TEA-Lab/DOGlove/docs/chapters/the_hardware.md

# Hardware

DOGlove’s hardware consists of two main components: the electronics for sensing and control, and the mechanical structure for physical interaction.

```{toctree}
:hidden:
:maxdepth: 1

../hardware/01_circuit.rst
../hardware/02_mechanical.md
```

## Circuit Design

Learn how we designed the electronics for DOGlove, including the schematic, PCB layout, and how to import or preview the project:

* [Circuit Design](../hardware/01_circuit.rst)

## Mechanical Design

Explore the mechanical structure of DOGlove through a full Onshape model, which can be exported in various formats:

* [Mechanical Design](../hardware/02_mechanical.md)
