TEA-Lab/DOGlove/docs/_static/quick_start/pcba/BOM_DOGlove_MainBoard_DOGlove_MainBoard.xlsx

No. | Quantity | Comment | Designator | Footprint | Value | Manufacturer Part | Manufacturer | Supplier Part | Supplier
1 | 2 | 10uF | C1,C2 | CASE-C_6032 | 10uF | TAJC106K035RNJ | Kyocera AVX | C7211 | LCSC
2 | 1 | 4.7uF | C3 | C0603 | 4.7uF | CL10A475KO8NNNC | SAMSUNG(三星) | C19666 | LCSC
3 | 3 | 100nF | C4,C5,C23 | C0603 | 100nF | CL10B104KB8NNNC | SAMSUNG(三星) | C1591 | LCSC
4 | 16 | 10nF | C6,C7,C8,C9,C10,C11,C12,C13,C14,C15,C16,C17,C18,C19,C20,C21 | C0603 | 10nF | CC0603JRX7R9BB103 | YAGEO(国巨) | C115056 | LCSC
5 | 1 | 47uF | C22 | CAP-SMD_L3.5-W2.8-R-RD | 47uF | CA45-B-16V-47uF-K | CEC(振华新云) | C136751 | LCSC
6 | 1 | 100pF | C24 | C0603 | 100pF | CL10C101JB8NNNC | SAMSUNG(三星) | C14858 | LCSC
7 | 5 | 1uF | C25,C26,C27,C28,C29 | C0603 | 1uF | CL10A105KB8NNNC | SAMSUNG(三星) | C15849 | LCSC
8 | 1 | XH-3AW | CN1 | CONN-TH_3P-P2.54_HCTL_XH-3AW |  | XH-3AW | HCTL(华灿天禄) | C2908612 | LCSC
9 | 3 | B3B-EH-A(LF)(SN) | CN2,CN3,CN4 | CONN-TH_B3B-EH-A-LF-SN |  | B3B-EH-A(LF)(SN) | JST | C160259 | LCSC
10 | 1 | XT30UPB-M | CN5 | CONN-TH_XT30UPB-M |  | XT30UPB-M | AMASS(艾迈斯) | C428721 | LCSC
11 | 1 | XT30PW-M30.G.Y | CN6 | CONN-TH_XT30PW-M |  | XT30PW-M30.G.Y | AMASS(艾迈斯) | C431092 | LCSC
12 | 1 | PZ254V-11-04P | H1 | HDR-TH_4P-P2.54-V-M |  | PZ254V-11-04P | XFCN(兴飞) | C2691448 | LCSC
13 | 4 | PZ254V-11-02P | H2,H3,H4,H5 | HDR-TH_2P-P2.54-V-M |  | PZ254V-11-02P | XFCN(兴飞) | C492401 | LCSC
14 | 2 | PZ254V-11-03P | H6,H7 | HDR-TH_3P-P2.54-V-M |  | PZ254V-11-03P | XFCN(兴飞) | C2937625 | LCSC
15 | 2 | NCD0603R1 | LED1,LED2 | LED0603-RD_RED |  | NCD0603R1 | 国星光电 | C84263 | LCSC
16 | 2 | NCD0603G1 | LED3,LED4 | LED0603-RD_1 |  | NCD0603G1 | 国星光电 | C84267 | LCSC
17 | 18 | 10kΩ | R1,R3,R35,R36,R37,R38,R39,R40,R41,R42,R43,R44,R45,R46,R47,R48,R49,R50 | R0603 | 10kΩ | 0603WAF1002T5E | UNI-ROYAL(厚声) | C25804 | LCSC
18 | 1 | NC | R2 | R0603 | NC | 0603WAF0000T5E | UNI-ROYAL(厚声) |  | LCSC
19 | 6 | 0Ω | R4,R13,R24,R25,R31,R33 | R0603 | 0Ω | 0603WAF0000T5E | UNI-ROYAL(厚声) | C21189 | LCSC
20 | 4 | 4.7kΩ | R5,R6,R7,R8 | R0603 | 4.7kΩ | 0603WAF4701T5E | UNI-ROYAL(厚声) | C23162 | LCSC
21 | 16 | 1kΩ | R9,R10,R11,R12,R14,R15,R16,R17,R18,R19,R20,R21,R26,R27,R28,R29 | R0603 | 1kΩ | 0603WAF1001T5E | UNI-ROYAL(厚声) | C21190 | LCSC
22 | 5 | 100Ω | R22,R23,R30,R32,R34 | R0603 | 100Ω | 0603WAF1000T5E | UNI-ROYAL(厚声) | C22775 | LCSC
23 | 1 | LM1117MPX-3.3/NOPB | U1 | SOT-223-3_L6.5-W3.4-P2.30-LS7.0-BR |  | LM1117MPX-3.3/NOPB | TI(德州仪器) | C9662 | LCSC
24 | 1 | STM32F042K6T6 | U2 | LQFP-32_L7.0-W7.0-P0.80-LS9.0-BL |  | STM32F042K6T6 | ST(意法半导体) | C69216 | LCSC
25 | 2 | ADS1256IDBR | U3,U4 | SSOP-28_L10.2-W5.3-P0.65-LS7.8-BL |  | ADS1256IDBR | TI(德州仪器) | C28186 | LCSC
26 | 1 | TL431BIDBZR | U5 | SOT-23-3_L2.9-W1.3-P1.90-LS2.4-BR |  | TL431BIDBZR | TI(德州仪器) | C41283 | LCSC
27 | 1 | PCA9548APW,118 | U6 | TSSOP-24_L7.8-W4.4-P0.65-LS6.4-BL |  | PCA9548APW,118 | NXP(恩智浦) | C21198 | LCSC
28 | 5 | DRV2605LDGSR | U7,U8,U9,U10,U11 | VSSOP-10_L3.0-W3.0-P0.50-LS4.9-BL |  | DRV2605LDGSR | TI(德州仪器) | C527464 | LCSC
29 | 16 | JS20T-S03PHA-00 | U12,U13,U14,U15,U18,U19,U20,U21,U24,U25,U26,U27,U29,U30,U31,U32 | CONN-TH_3P-P2.00_BX-PH2.0-3PZZ |  | JS20T-S03PHA-00 | JS(钜硕电子) | C7499293 | LCSC
30 | 5 | ZX-SH1.0-2PLT | U16,U17,U22,U23,U28 | CONN-SMD_2P-P1.00_MEGASTAR_ZX-SH1.0-2PLT |  | ZX-SH1.0-2PLT | Megastar(兆星) | C7430451 | LCSC
31 | 1 | SS-22F07-G100 | U33 | SW-TH_6P-L16.5-W7.5-P4.0-LS2.6-TL |  | SS-22F07-G100 | G-Switch(品赞) | C5446810 | LCSC
32 | 3 | {ManufacturerPart!} | X1,X2,X3 | OSC-SMD_3P-L3.2-W1.3-P1.20 |  | CSTNE8M00G520000R0 | muRata(村田) | C907975 | LCSC
