TEA-Lab/DOGlove/DOGlove_meshes/pinky_bend_2.STL

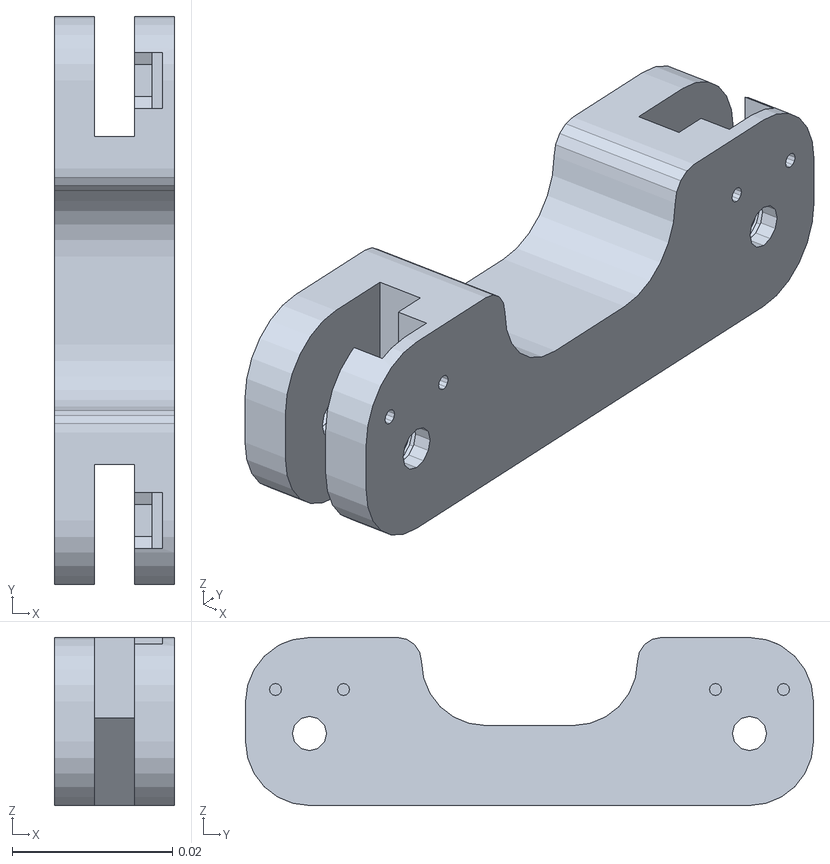
[picture p16: CAD file, 2025-06-23]
DOGlove_meshes/pinky_bend_2.STL
0.015 x 0.071 x 0.021
