TEA-Lab/DOGlove/hand_meshes/inspire_hand/meshes/Link11.STL

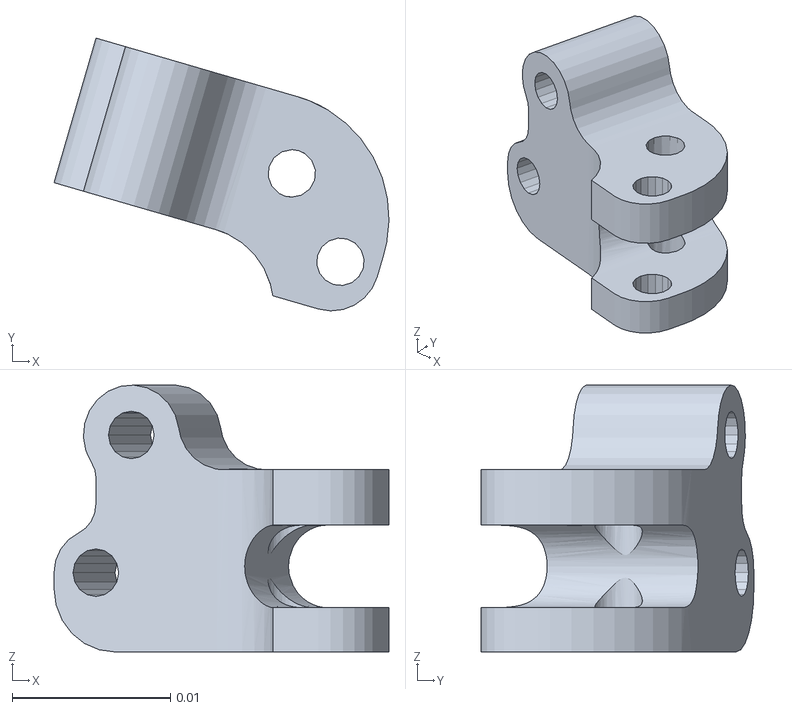
[picture p17: CAD file, 2026-03-28]
hand_meshes/inspire_hand/meshes/Link11.STL
0.0211 x 0.0172 x 0.0168
