TEA-Lab/DOGlove/hand_meshes/leap_hand/meshes/thumb_pip.stl

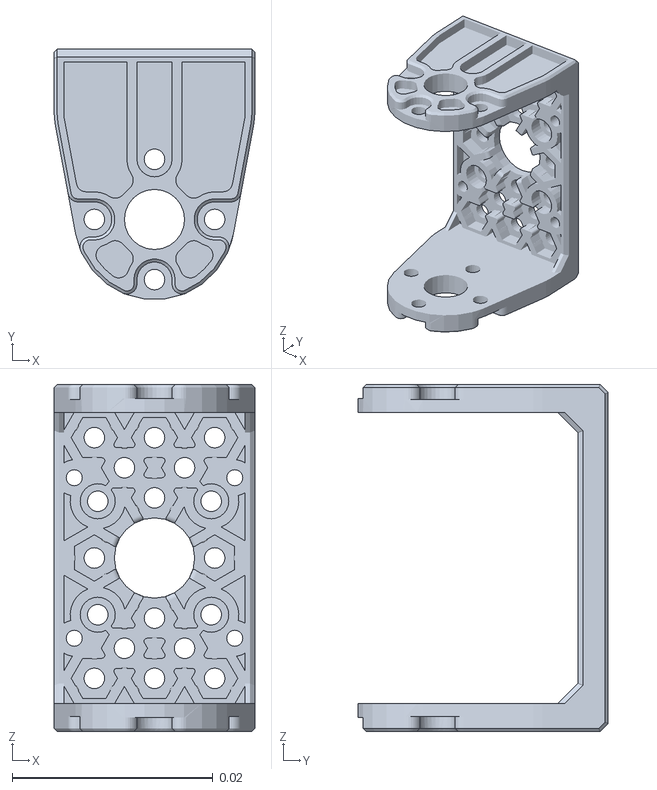
[picture p18: CAD file, 2026-03-28]
hand_meshes/leap_hand/meshes/thumb_pip.stl
0.02 x 0.0249 x 0.0346
