TEA-Lab/DOGlove/hand_meshes/shadow_hand/assets/th_proximal.obj

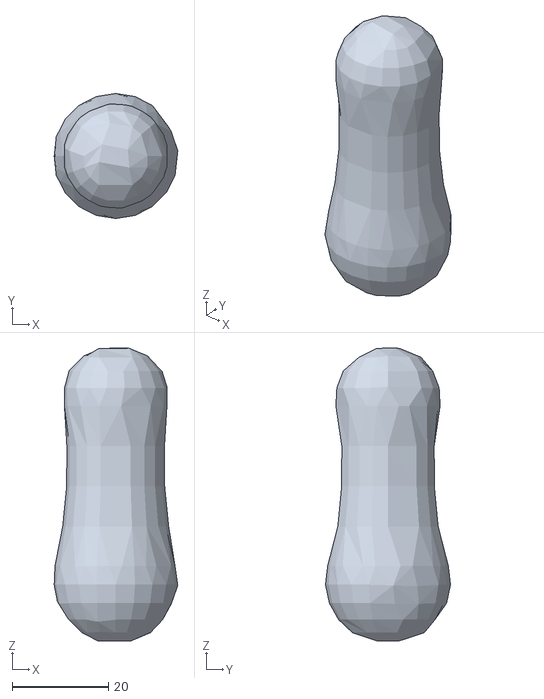
[picture p19: CAD file, 2026-03-28]
hand_meshes/shadow_hand/assets/th_proximal.obj
25.7 x 26.0 x 60.8
