TEA-Lab/DOGlove/hand_meshes/wonik_allegro/assets/link_12.0_left.stl

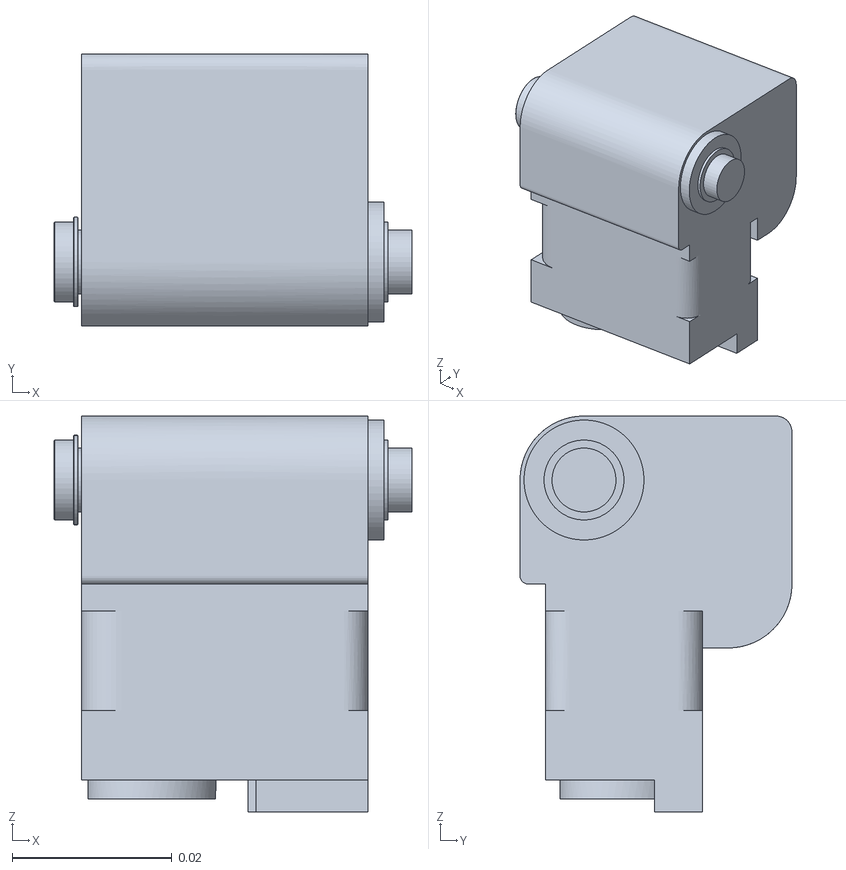
[picture p20: CAD file, 2026-03-28]
hand_meshes/wonik_allegro/assets/link_12.0_left.stl
0.0447 x 0.034 x 0.0495
