TEA-Lab/DOGlove/DOGlove_meshes/index_bend_3.STL

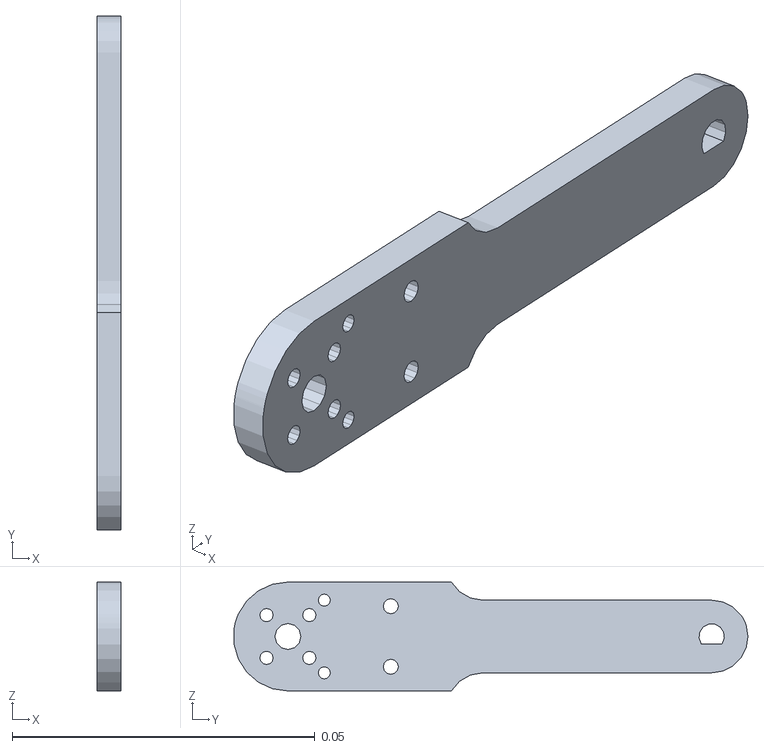
[picture p21: CAD file, 2025-06-23]
DOGlove_meshes/index_bend_3.STL
0.004 x 0.0849 x 0.018
