TEA-Lab/DOGlove/hand_meshes/inspire_hand/meshes/Link14.STL

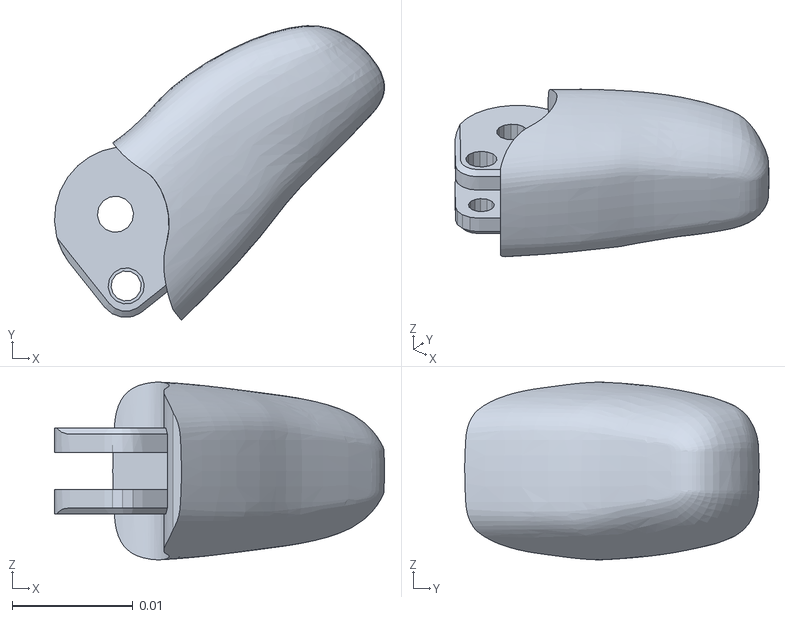
[picture p22: CAD file, 2026-03-28]
hand_meshes/inspire_hand/meshes/Link14.STL
0.0273 x 0.0244 x 0.0147
