TEA-Lab/DOGlove/hand_meshes/leap_hand/meshes/thumb_dip.stl

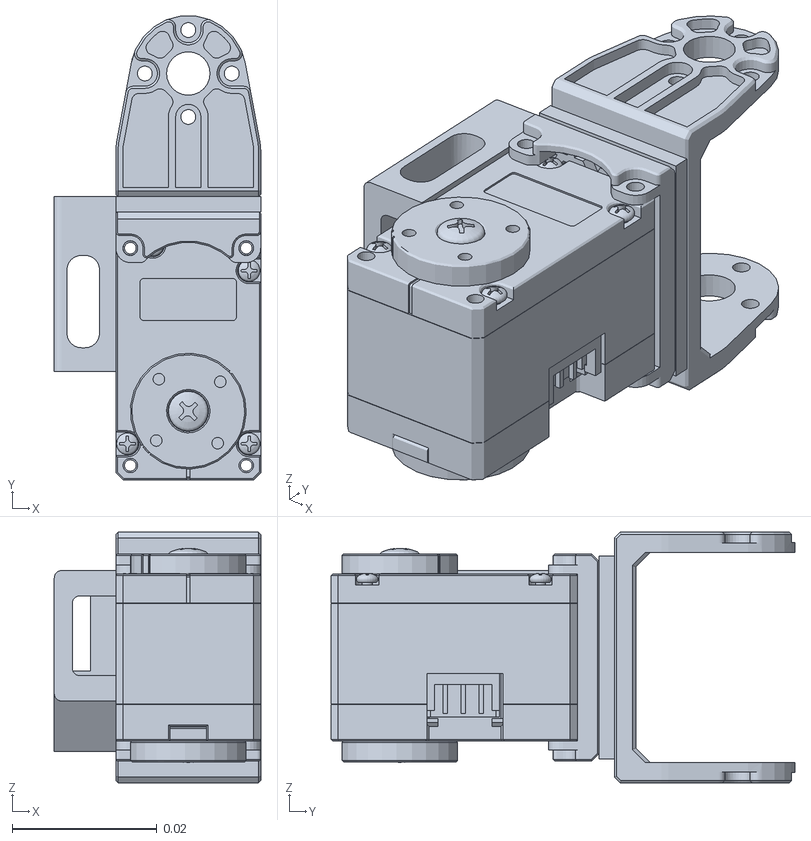
[picture p23: CAD file, 2026-03-28]
hand_meshes/leap_hand/meshes/thumb_dip.stl
0.0285 x 0.064 x 0.0346
