TEA-Lab/DOGlove/hand_meshes/shadow_hand/assets/th_distal_pst.obj

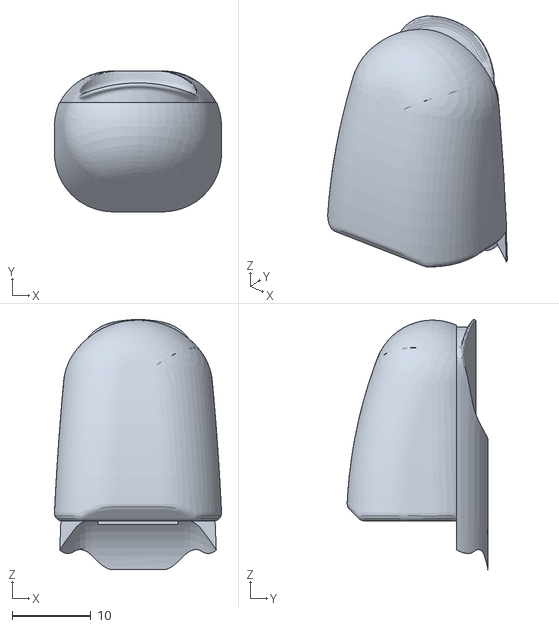
[picture p24: CAD file, 2026-03-28]
hand_meshes/shadow_hand/assets/th_distal_pst.obj
21.2 x 17.8 x 31.7
