TEA-Lab/DOGlove/DOGlove_meshes/middle_split.STL

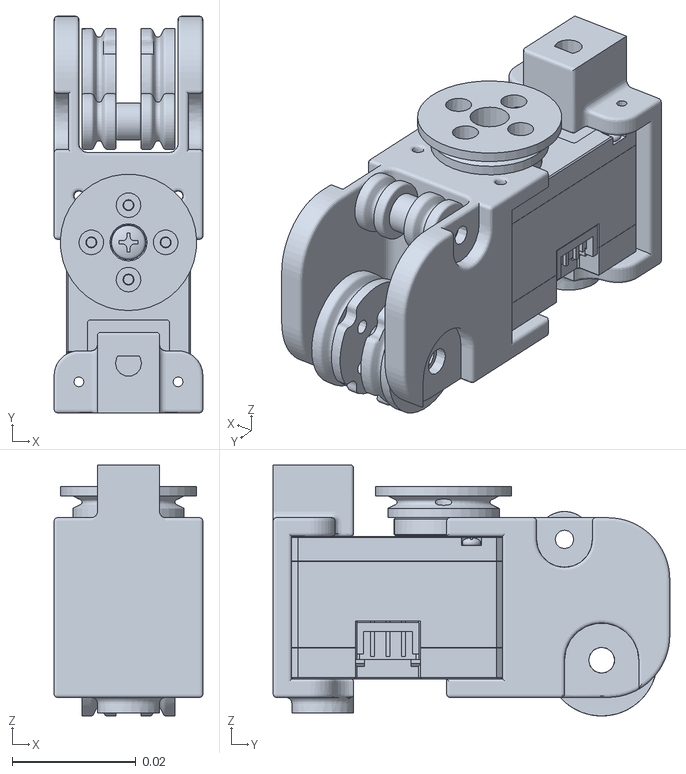
[picture p26: CAD file, 2025-06-23]
DOGlove_meshes/middle_split.STL
0.024 x 0.064 x 0.0405
