TEA-Lab/DOGlove/hand_meshes/inspire_hand/meshes/Link19.STL

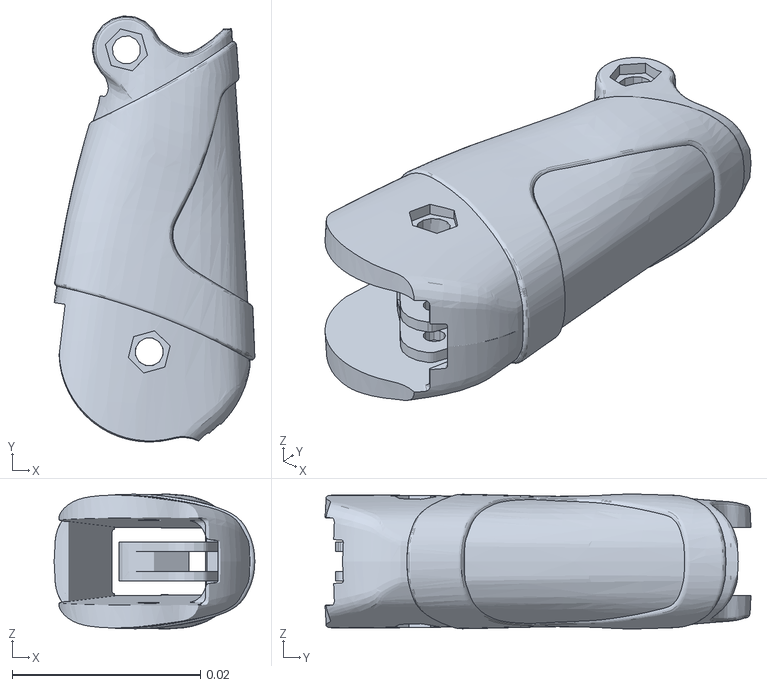
[picture p27: CAD file, 2026-03-28]
hand_meshes/inspire_hand/meshes/Link19.STL
0.0213 x 0.0452 x 0.0143
