TEA-Lab/DOGlove/hand_meshes/leap_hand/meshes/pip.stl

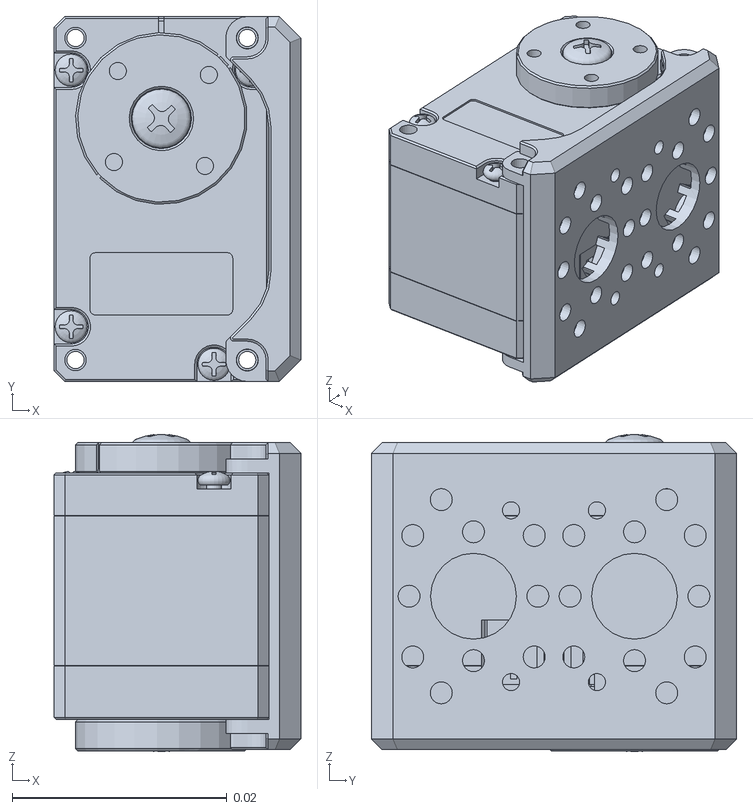
[picture p28: CAD file, 2026-03-28]
hand_meshes/leap_hand/meshes/pip.stl
0.023 x 0.034 x 0.0295
