TEA-Lab/DOGlove/hand_meshes/shadow_hand/assets/f_distal_pst.obj

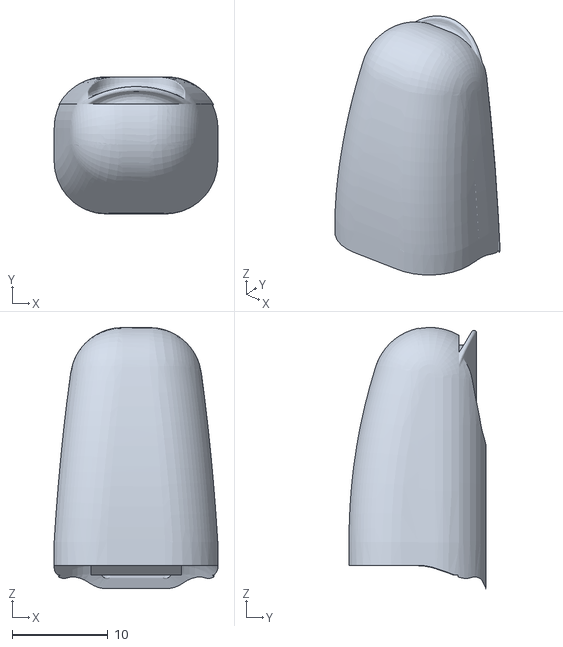
[picture p29: CAD file, 2026-03-28]
hand_meshes/shadow_hand/assets/f_distal_pst.obj
17.1 x 14.3 x 27.3
