TEA-Lab/DOGlove/hand_meshes/wonik_allegro/assets/link_15.0_tip.stl

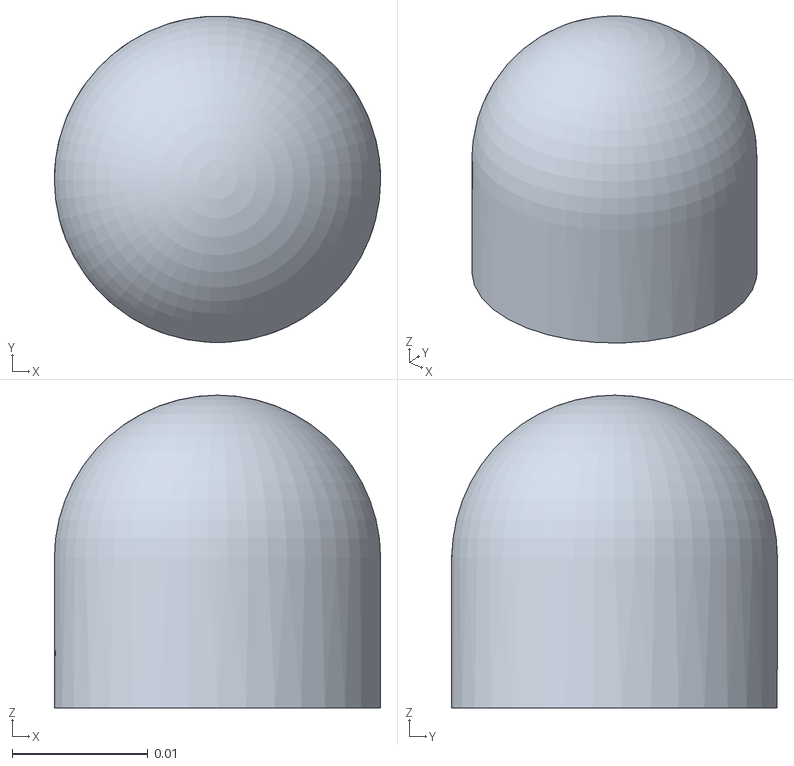
[picture p30: CAD file, 2026-03-28]
hand_meshes/wonik_allegro/assets/link_15.0_tip.stl
0.024 x 0.024 x 0.023
