TEA-Lab/DOGlove/DOGlove_meshes/thumb_bend_1.STL

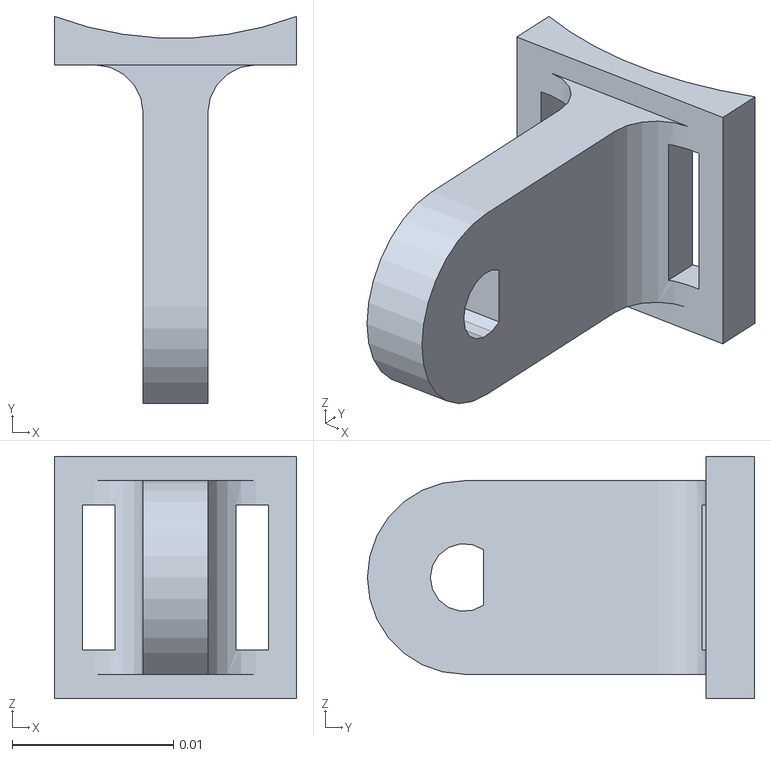
[picture p31: CAD file, 2025-06-23]
DOGlove_meshes/thumb_bend_1.STL
0.015 x 0.024 x 0.015
