TEA-Lab/DOGlove/hand_meshes/leap_hand/meshes/mcp_joint.stl

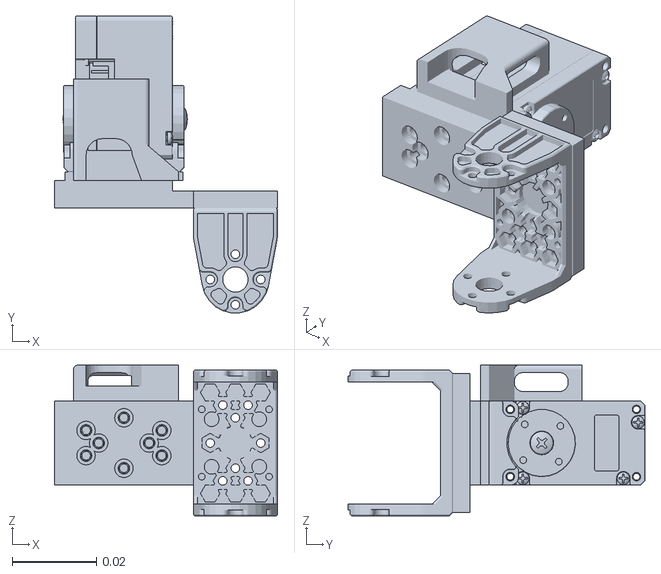
[picture p32: CAD file, 2026-03-28]
hand_meshes/leap_hand/meshes/mcp_joint.stl
0.053 x 0.0705 x 0.0358
