TEA-Lab/DOGlove/hand_meshes/shadow_hand/assets/wrist.obj

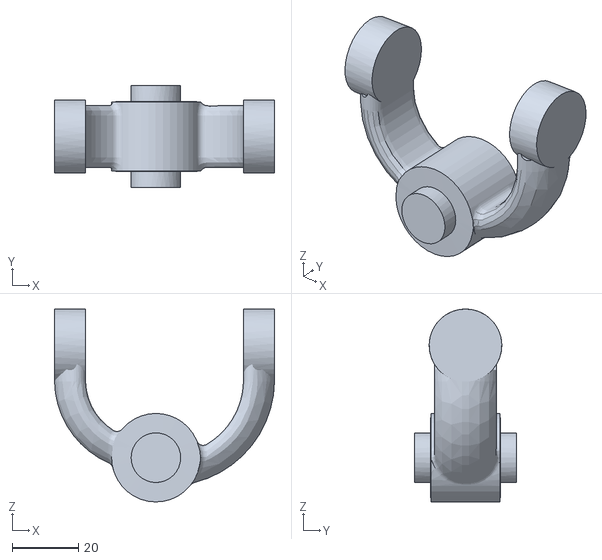
[picture p33: CAD file, 2026-03-28]
hand_meshes/shadow_hand/assets/wrist.obj
66.6 x 30.8 x 58.4
