TEA-Lab/DOGlove/hand_meshes/wonik_allegro/assets/link_13.0.stl

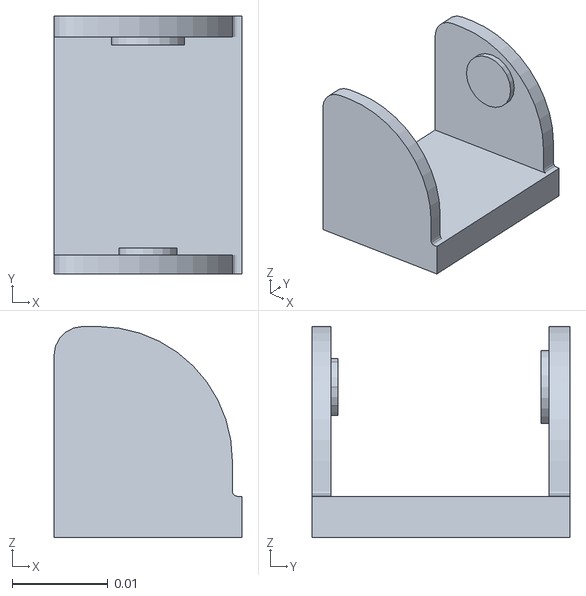
[picture p34: CAD file, 2026-03-28]
hand_meshes/wonik_allegro/assets/link_13.0.stl
0.0196 x 0.0269 x 0.022
