TEA-Lab/DOGlove/hand_meshes/inspire_hand/meshes/base_link.STL

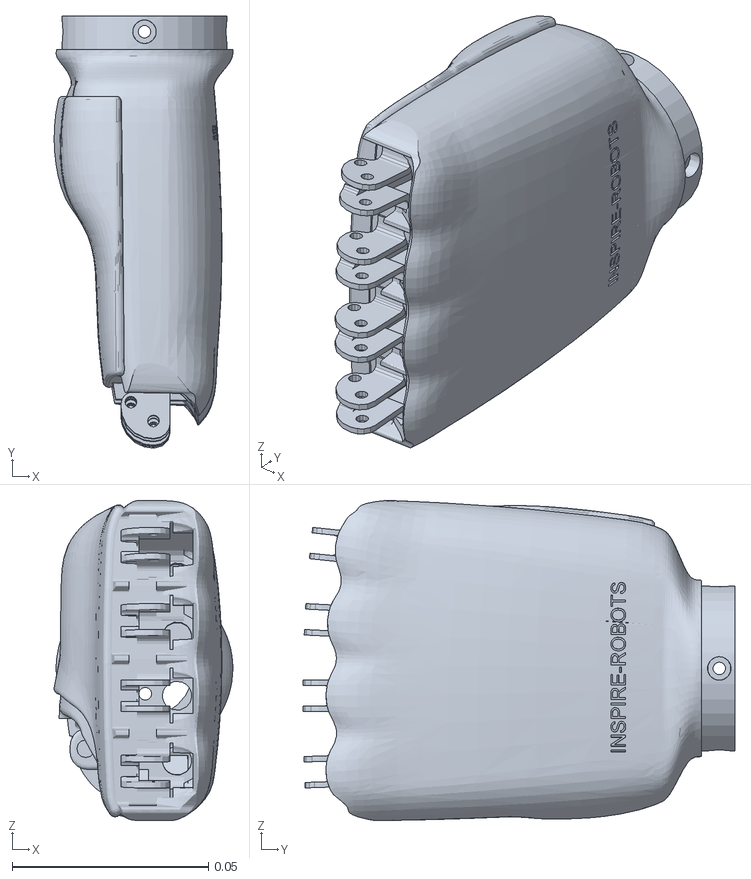
[picture p35: CAD file, 2026-03-28]
hand_meshes/inspire_hand/meshes/base_link.STL
0.0455 x 0.11 x 0.0815
