TEA-Lab/DOGlove/hand_meshes/leap_hand/meshes/dip.stl

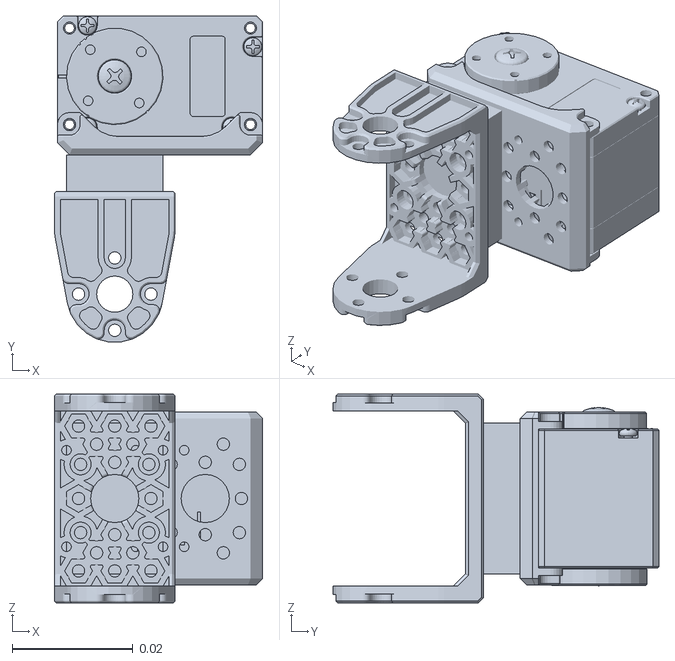
[picture p36: CAD file, 2026-03-28]
hand_meshes/leap_hand/meshes/dip.stl
0.0345 x 0.054 x 0.0346
