TEA-Lab/DOGlove/hand_meshes/shadow_hand/assets/f_knuckle.obj

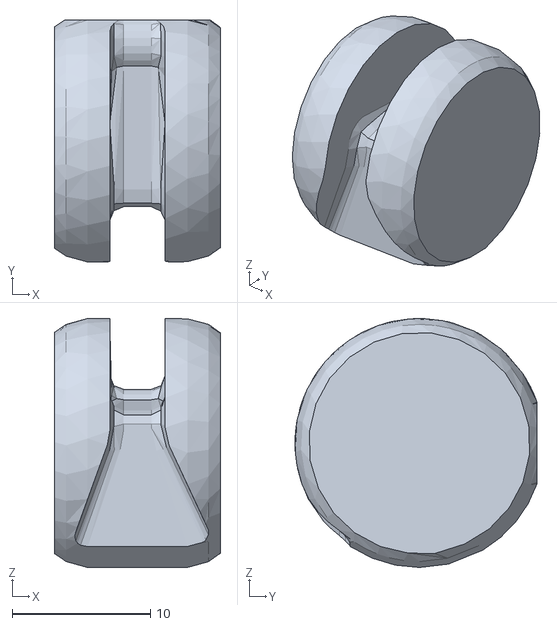
[picture p37: CAD file, 2026-03-28]
hand_meshes/shadow_hand/assets/f_knuckle.obj
12.0 x 17.5 x 18.0
