TEA-Lab/DOGlove/DOGlove_meshes/ring_bend_2.STL

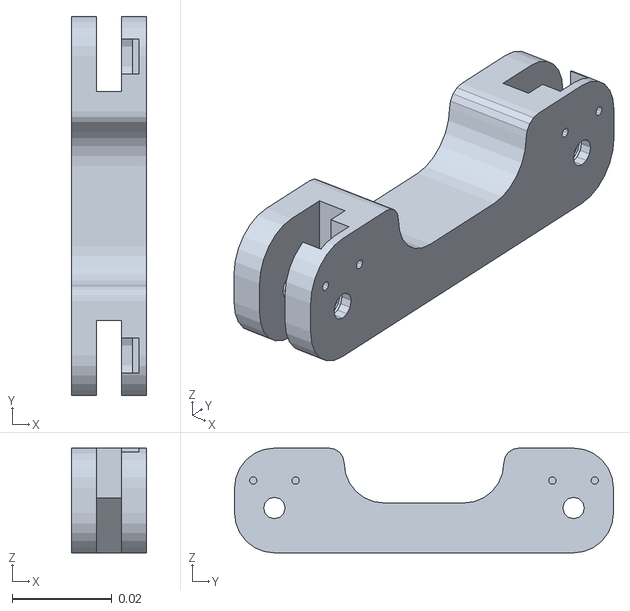
[picture p39: CAD file, 2025-06-23]
DOGlove_meshes/ring_bend_2.STL
0.015 x 0.076 x 0.021
