TEA-Lab/DOGlove/hand_meshes/inspire_hand/meshes/Link18.STL

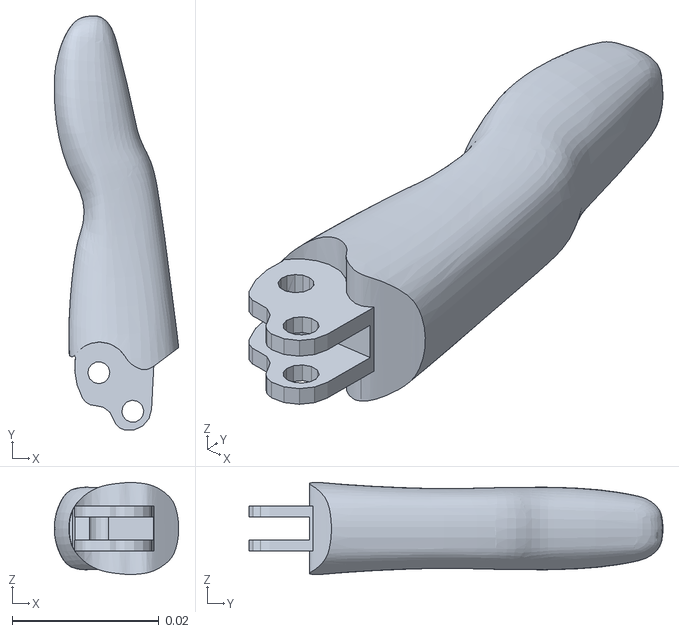
[picture p40: CAD file, 2026-03-28]
hand_meshes/inspire_hand/meshes/Link18.STL
0.017 x 0.0565 x 0.0126
