TEA-Lab/DOGlove/hand_meshes/leap_hand/meshes/fingertip.stl

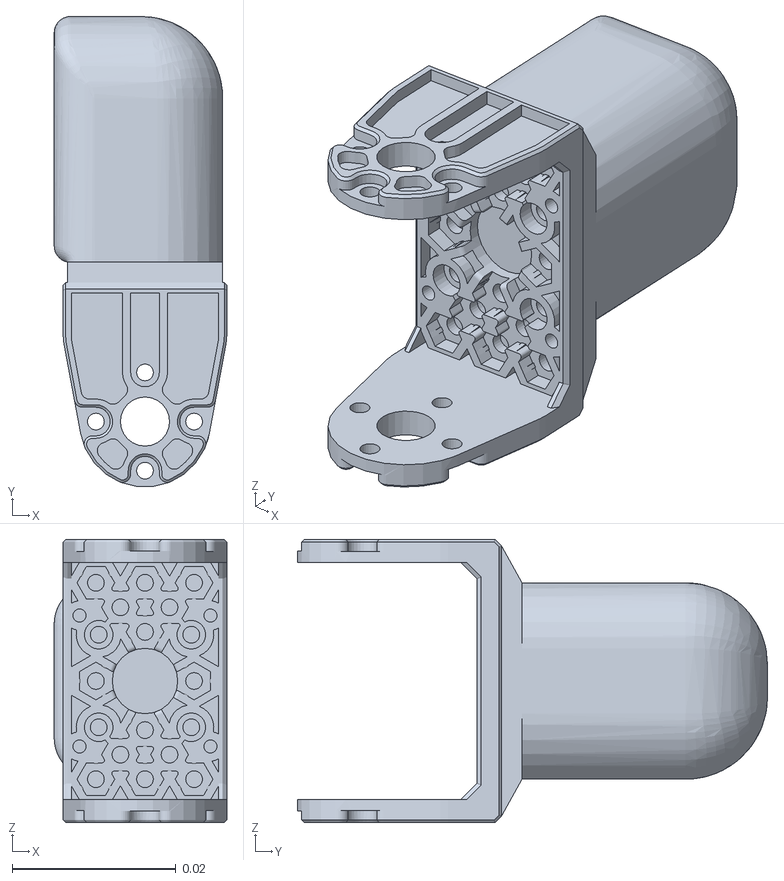
[picture p41: CAD file, 2026-03-28]
hand_meshes/leap_hand/meshes/fingertip.stl
0.0211 x 0.0574 x 0.0346
