TEA-Lab/DOGlove/hand_meshes/shadow_hand/assets/forearm_collision.obj

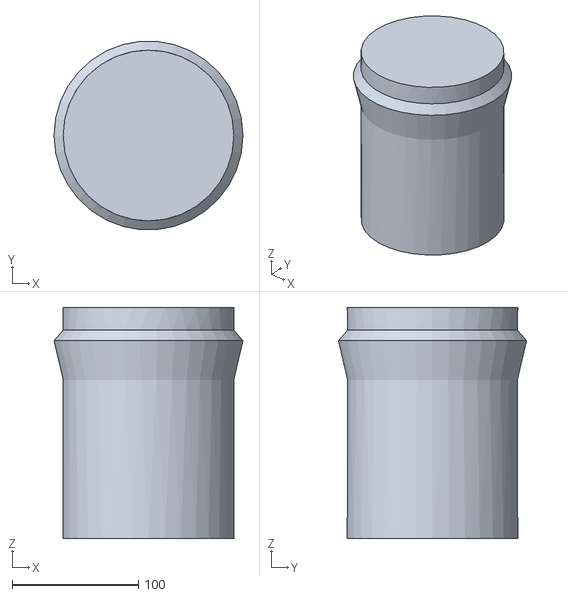
[picture p42: CAD file, 2026-03-28]
hand_meshes/shadow_hand/assets/forearm_collision.obj
149.5 x 148.9 x 182.8
