TEA-Lab/DOGlove/hand_meshes/wonik_allegro/assets/base_link.stl

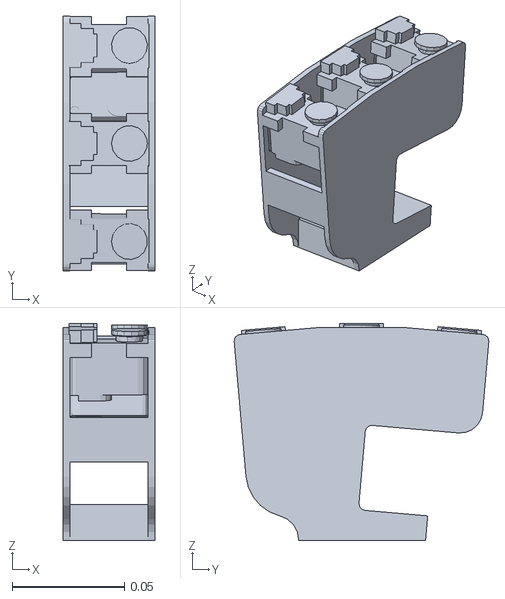
[picture p43: CAD file, 2026-03-28]
hand_meshes/wonik_allegro/assets/base_link.stl
0.0408 x 0.113 x 0.0967
