TEA-Lab/DOGlove/DOGlove_meshes/pinky_bend_3.STL

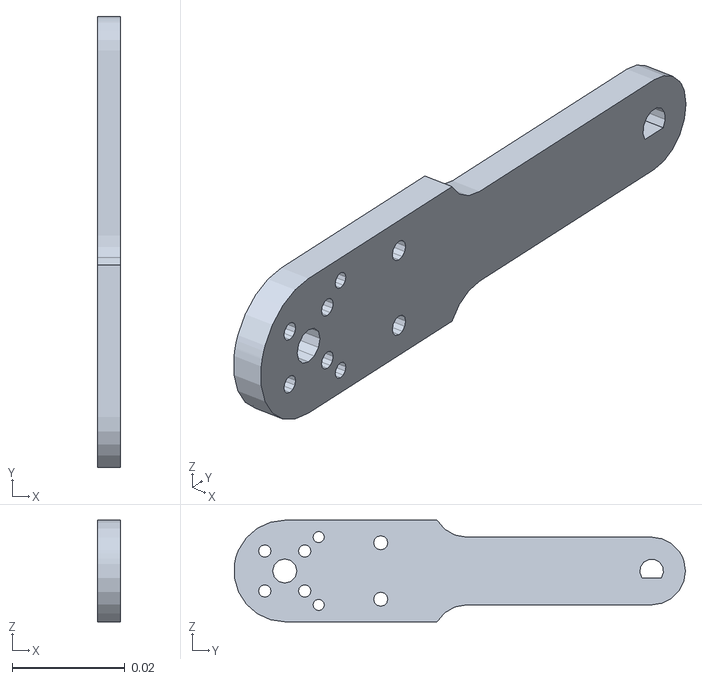
[picture p44: CAD file, 2025-06-23]
DOGlove_meshes/pinky_bend_3.STL
0.004 x 0.0799 x 0.018
