TEA-Lab/DOGlove/hand_meshes/leap_hand/meshes/thumb_fingertip.stl

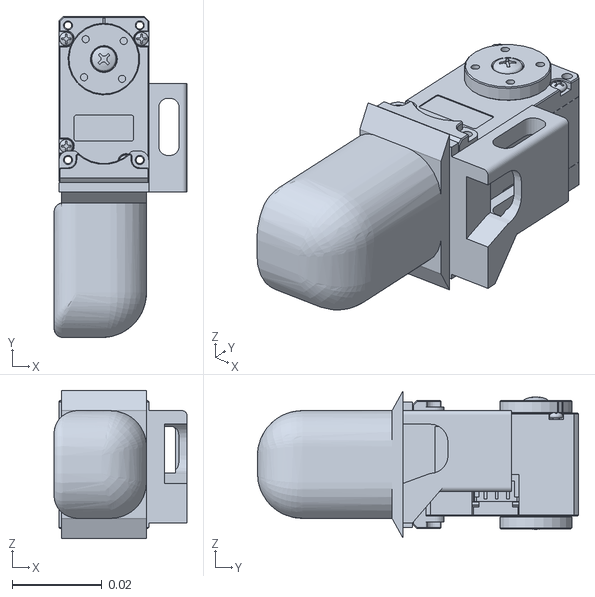
[picture p45: CAD file, 2026-03-28]
hand_meshes/leap_hand/meshes/thumb_fingertip.stl
0.0296 x 0.0716 x 0.033
