TEA-Lab/DOGlove/hand_meshes/shadow_hand/assets/forearm_1.obj

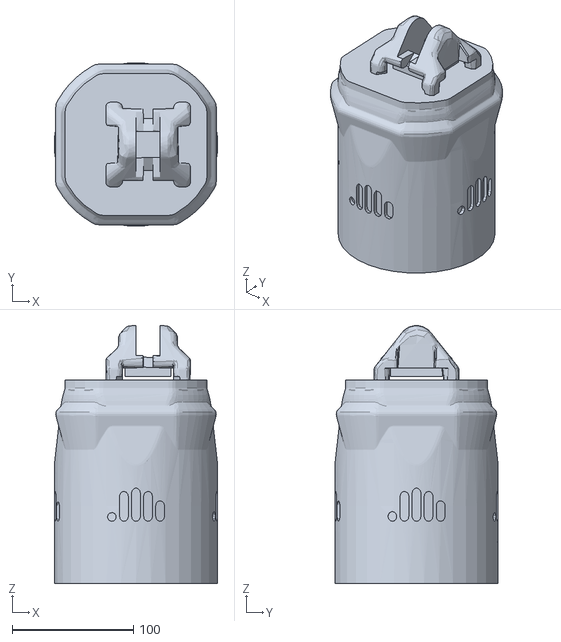
[picture p46: CAD file, 2026-03-28]
hand_meshes/shadow_hand/assets/forearm_1.obj
135.0 x 135.0 x 213.1
