TEA-Lab/DOGlove/hand_meshes/wonik_allegro/assets/link_1.0.stl

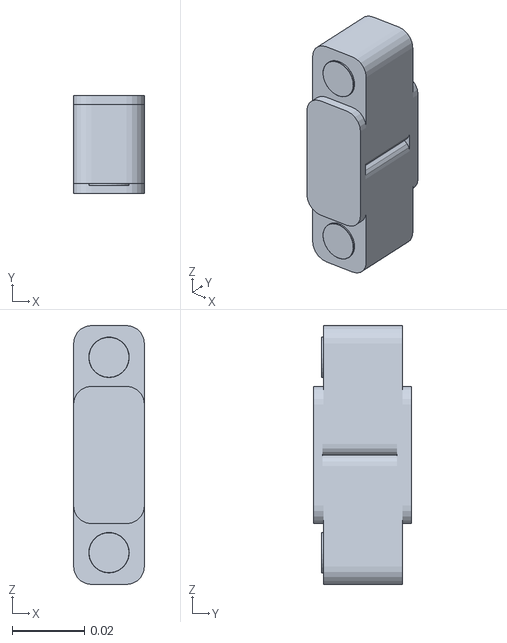
[picture p47: CAD file, 2026-03-28]
hand_meshes/wonik_allegro/assets/link_1.0.stl
0.0196 x 0.027 x 0.0716
