TEA-Lab/DOGlove/hand_meshes/inspire_hand/meshes/Link16.STL

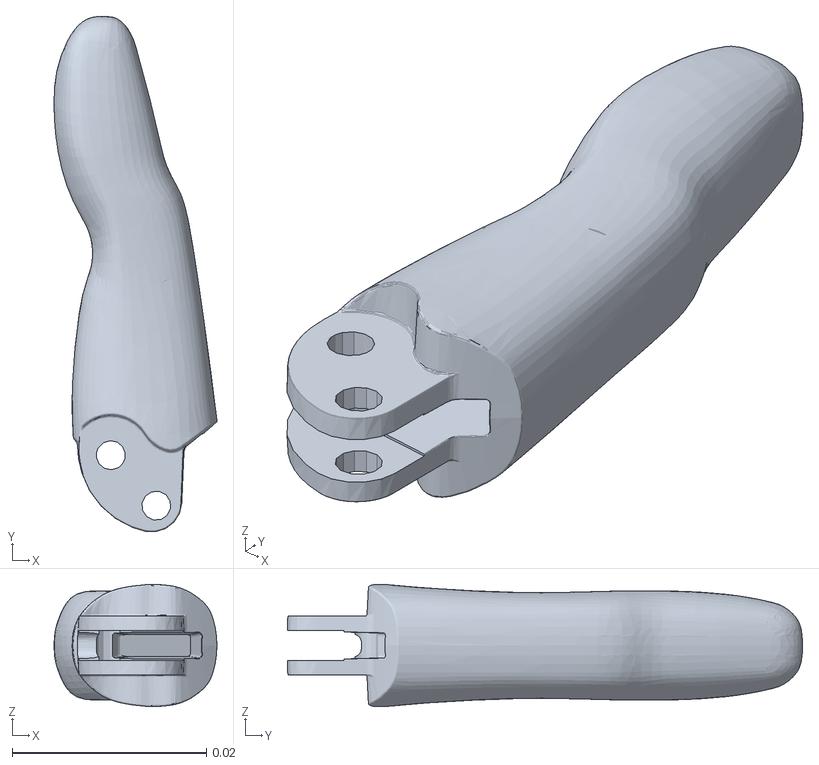
[picture p48: CAD file, 2026-03-28]
hand_meshes/inspire_hand/meshes/Link16.STL
0.0168 x 0.0531 x 0.0126
