TEA-Lab/DOGlove/hand_meshes/shadow_hand/assets/th_middle.obj

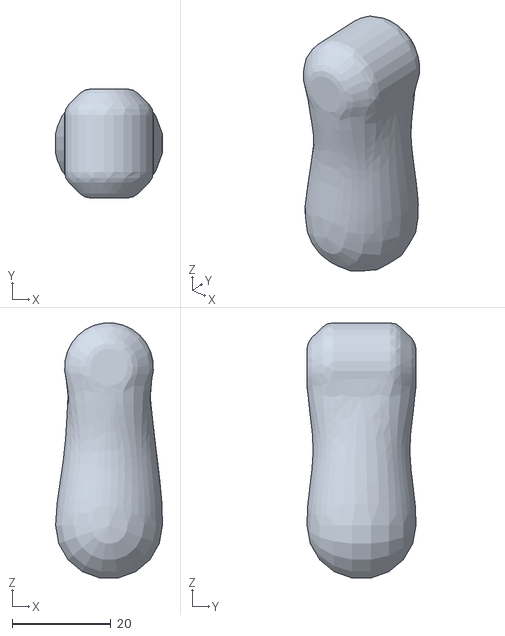
[picture p49: CAD file, 2026-03-28]
hand_meshes/shadow_hand/assets/th_middle.obj
21.6 x 22.1 x 51.6
