TEA-Lab/DOGlove/hand_meshes/inspire_hand/meshes/Link20.STL

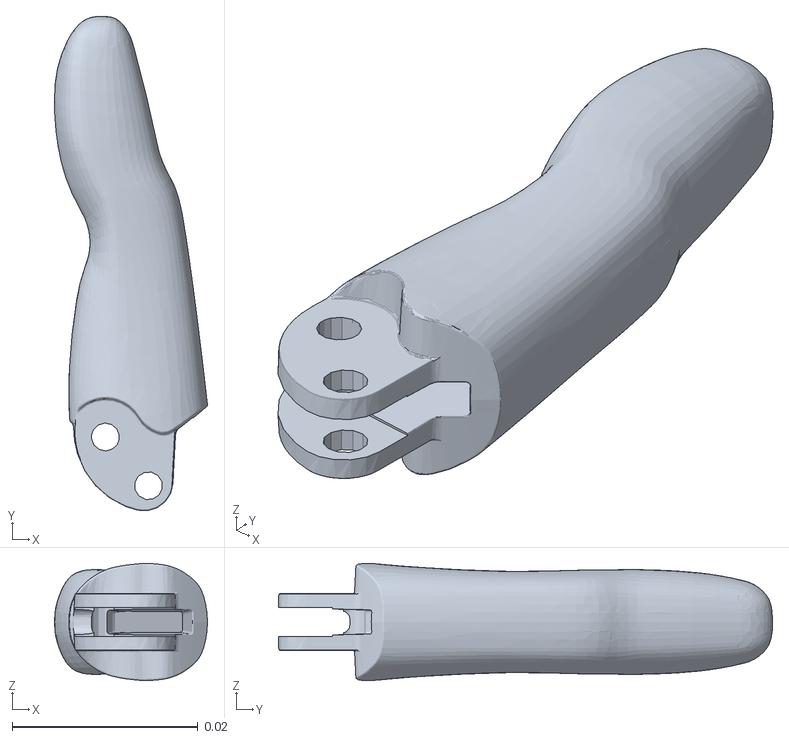
[picture p51: CAD file, 2026-03-28]
hand_meshes/inspire_hand/meshes/Link20.STL
0.0165 x 0.0532 x 0.0126
