TEA-Lab/DOGlove/hand_meshes/shadow_hand/assets/palm.obj

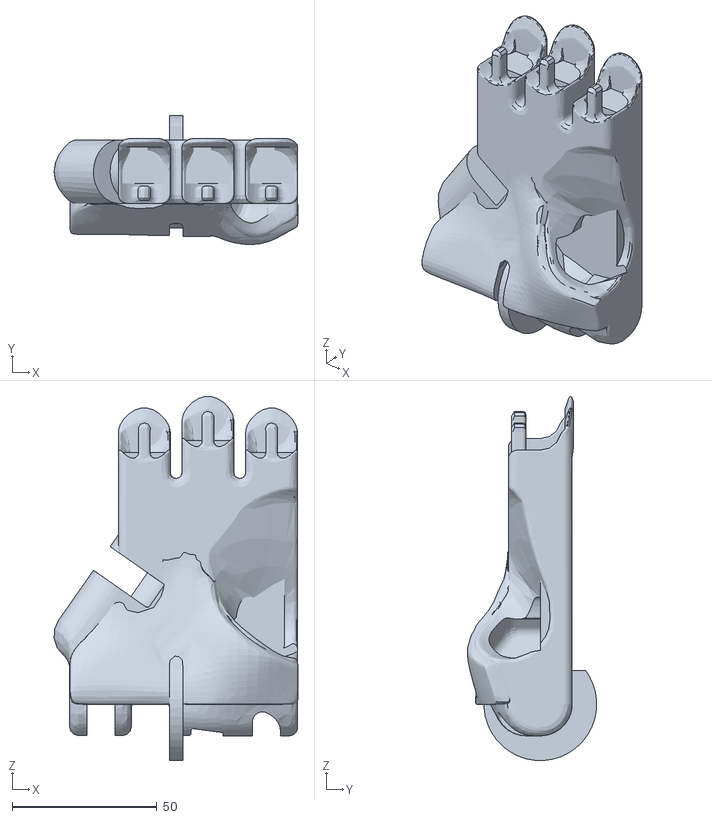
[picture p52: CAD file, 2026-03-28]
hand_meshes/shadow_hand/assets/palm.obj
84.3 x 44.7 x 125.8
