TEA-Lab/DOGlove/hand_meshes/inspire_hand/meshes/hand_base_link.STL

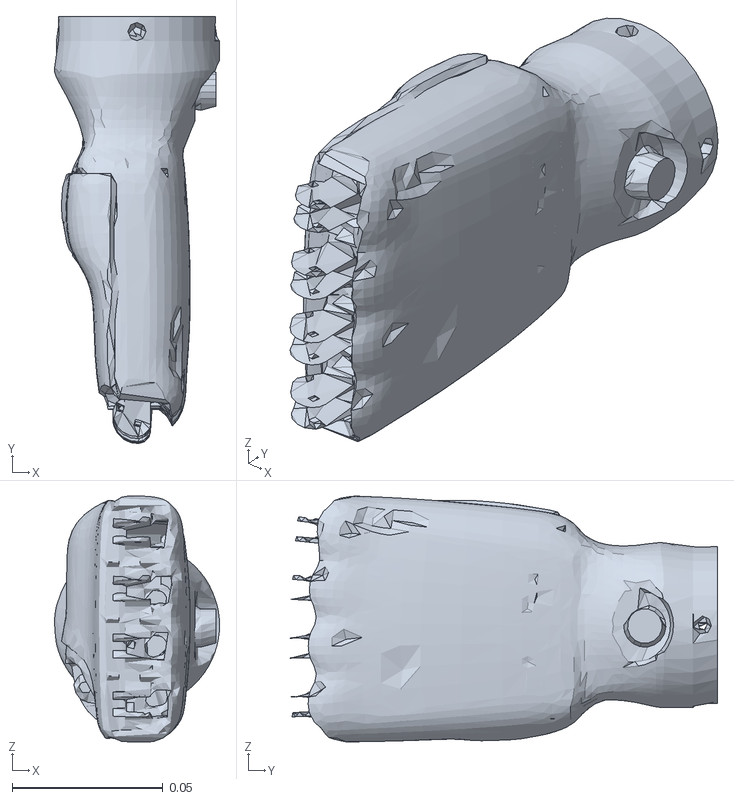
[picture p53: CAD file, 2026-03-28]
hand_meshes/inspire_hand/meshes/hand_base_link.STL
0.0547 x 0.142 x 0.0815
