TEA-Lab/DOGlove/hand_meshes/shadow_hand/assets/f_proximal.obj

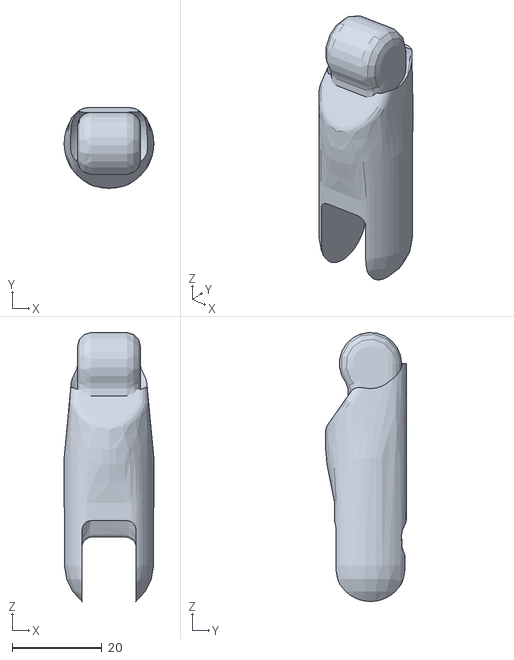
[picture p54: CAD file, 2026-03-28]
hand_meshes/shadow_hand/assets/f_proximal.obj
20.0 x 18.0 x 59.9
