TEA-Lab/DOGlove/DOGlove_meshes/thumb_bend_2.STL

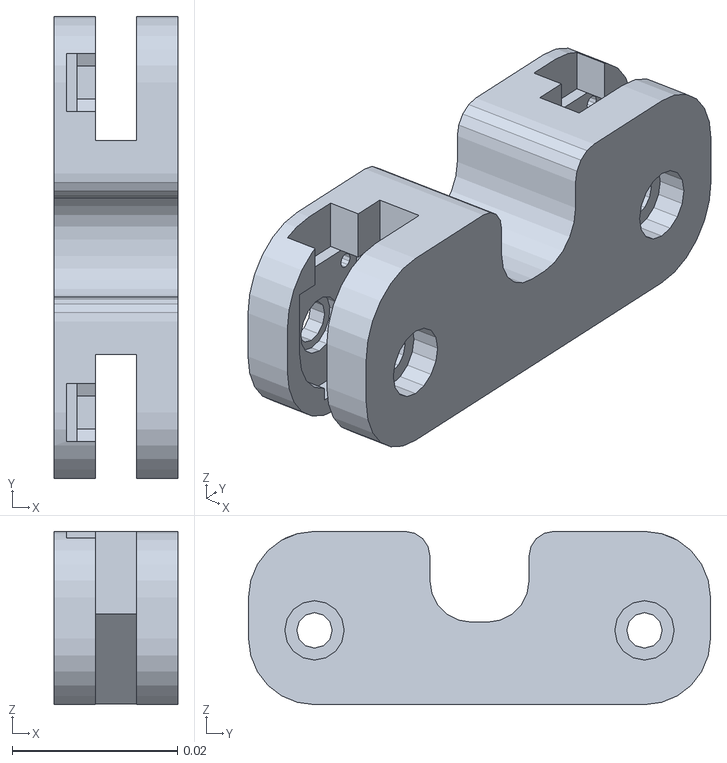
[picture p56: CAD file, 2025-06-23]
DOGlove_meshes/thumb_bend_2.STL
0.015 x 0.056 x 0.021
