TEA-Lab/DOGlove/hand_meshes/inspire_hand/meshes/Link22.STL

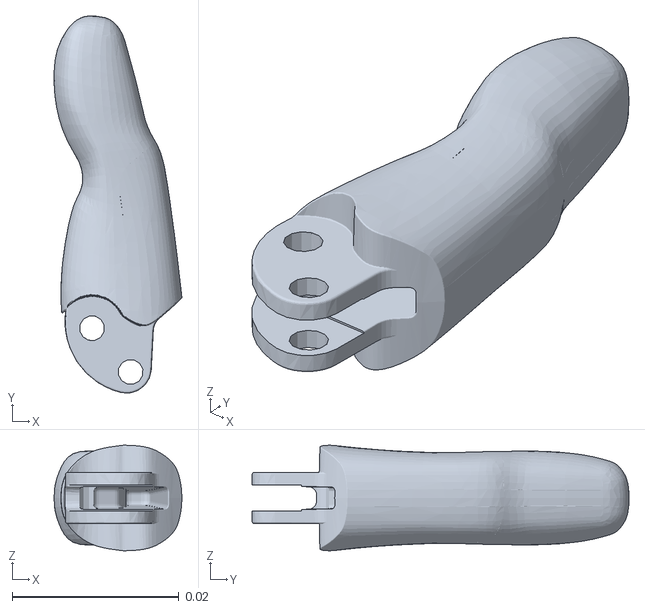
[picture p57: CAD file, 2026-03-28]
hand_meshes/inspire_hand/meshes/Link22.STL
0.0153 x 0.0452 x 0.0127
