TEA-Lab/DOGlove/hand_meshes/shadow_hand/assets/lf_metacarpal.obj

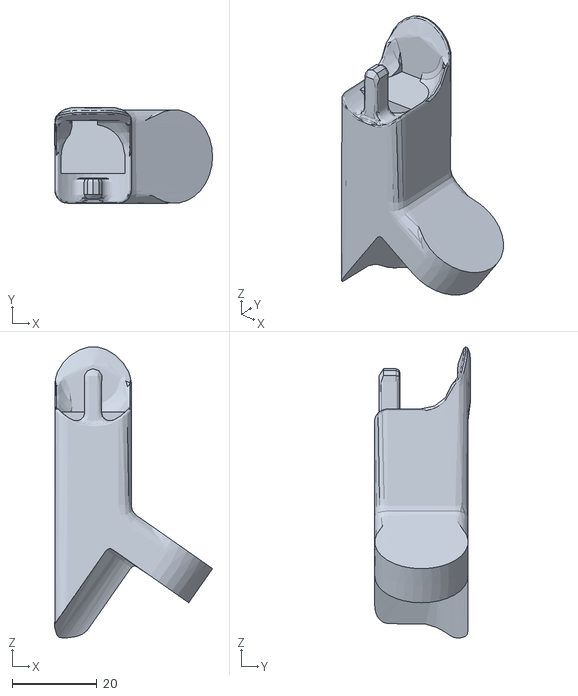
[picture p58: CAD file, 2026-03-28]
hand_meshes/shadow_hand/assets/lf_metacarpal.obj
37.3 x 22.5 x 68.5
