TEA-Lab/DOGlove/hand_meshes/wonik_allegro/assets/link_12.0_right.stl

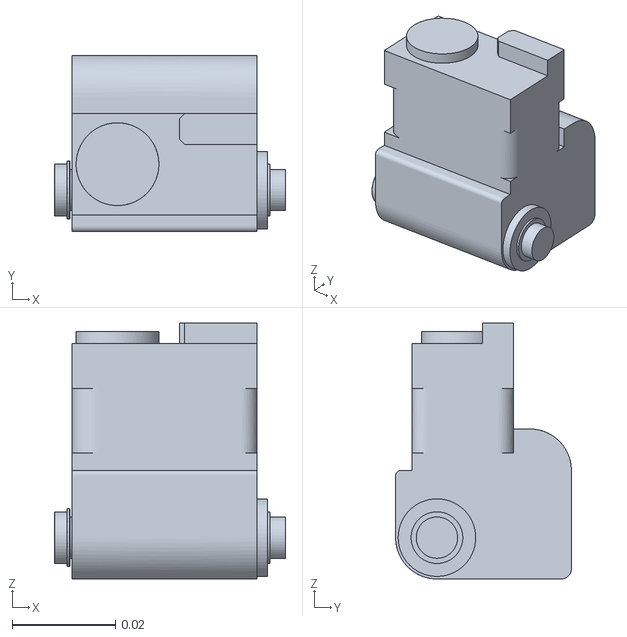
[picture p59: CAD file, 2026-03-28]
hand_meshes/wonik_allegro/assets/link_12.0_right.stl
0.0447 x 0.034 x 0.0495
