TEA-Lab/DOGlove/hand_meshes/inspire_hand/meshes/Link13.STL

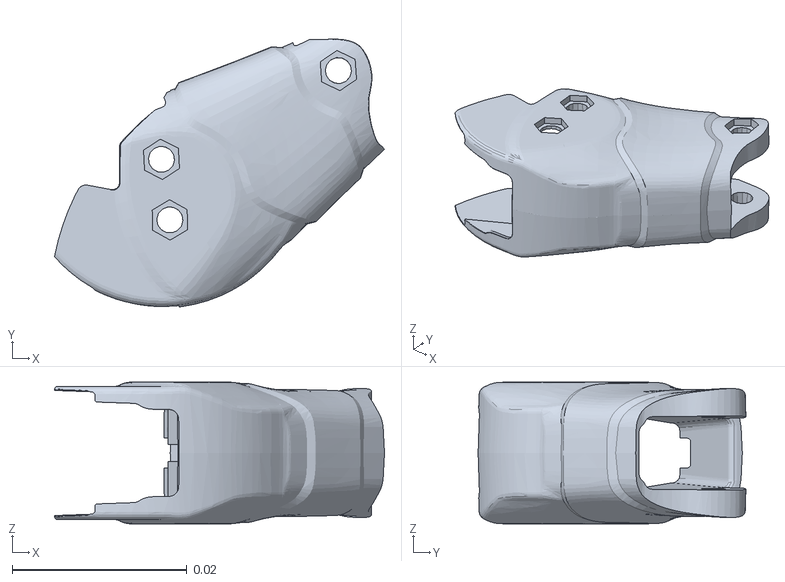
[picture p60: CAD file, 2026-03-28]
hand_meshes/inspire_hand/meshes/Link13.STL
0.0378 x 0.0306 x 0.0162
