TEA-Lab/DOGlove/hand_meshes/shadow_hand/assets/forearm_0.obj

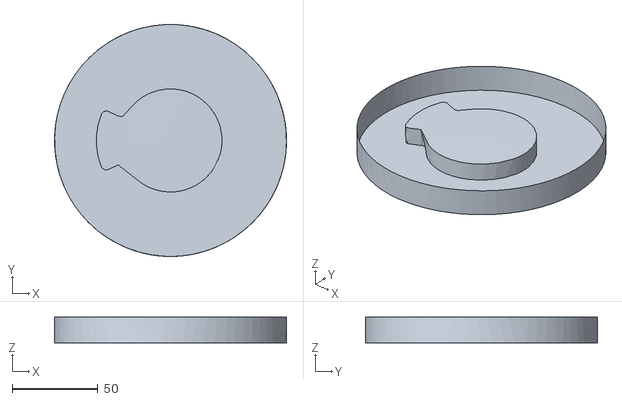
[picture p61: CAD file, 2026-03-28]
hand_meshes/shadow_hand/assets/forearm_0.obj
135.0 x 135.0 x 15.0
