TEA-Lab/DOGlove/DOGlove_meshes/thumb_split.STL

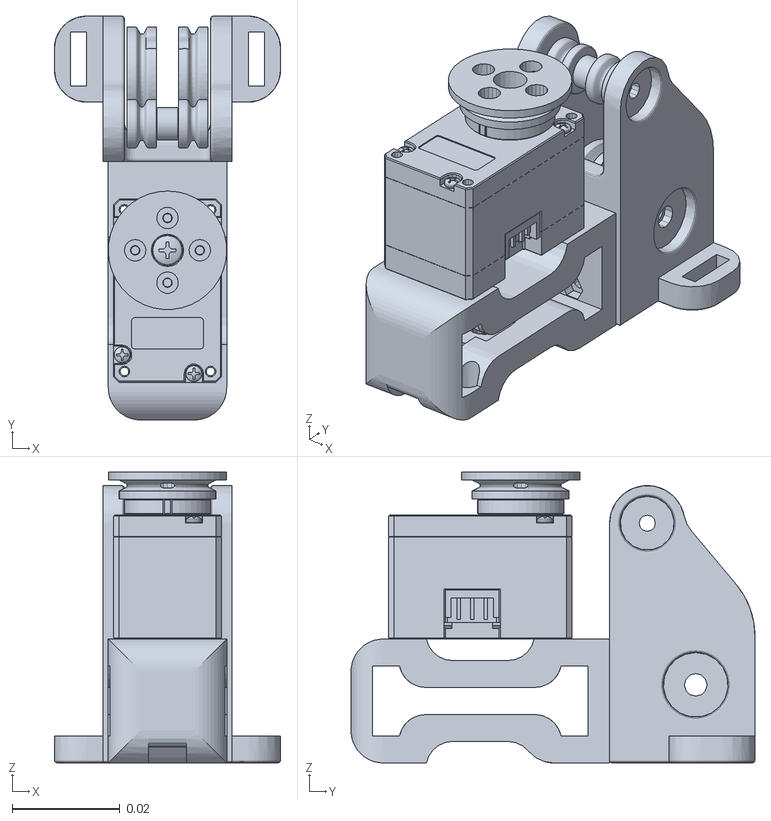
[picture p62: CAD file, 2025-06-23]
DOGlove_meshes/thumb_split.STL
0.042 x 0.075 x 0.054
