TEA-Lab/DOGlove/hand_meshes/inspire_hand/meshes/Link12.STL

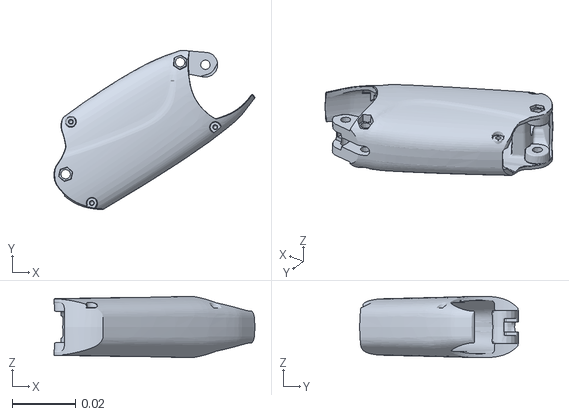
[picture p63: CAD file, 2026-03-28]
hand_meshes/inspire_hand/meshes/Link12.STL
0.0634 x 0.0501 x 0.0194
