TEA-Lab/DOGlove/hand_meshes/shadow_hand/assets/mounting_plate.obj

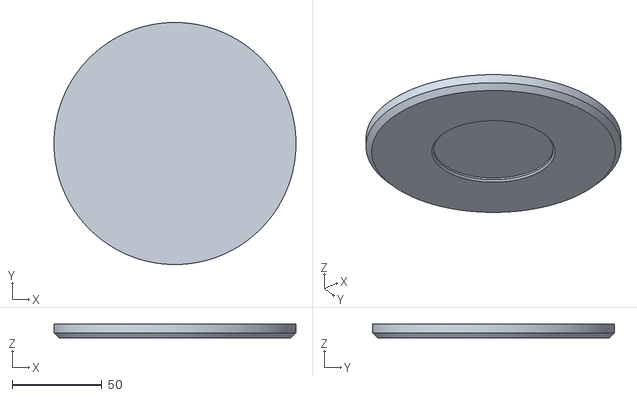
[picture p64: CAD file, 2026-03-28]
hand_meshes/shadow_hand/assets/mounting_plate.obj
135.0 x 135.0 x 8.00
