TEA-Lab/DOGlove/hand_meshes/shadow_hand/assets/f_middle.obj

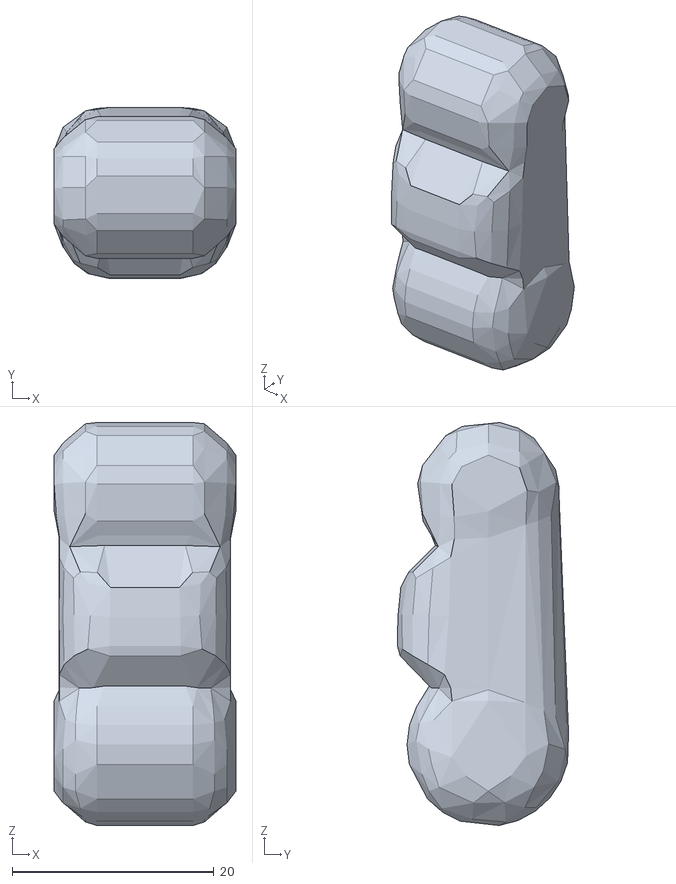
[picture p65: CAD file, 2026-03-28]
hand_meshes/shadow_hand/assets/f_middle.obj
18.0 x 17.0 x 39.9
