TEA-Lab/DOGlove/DOGlove_meshes/middle_bend_3.STL

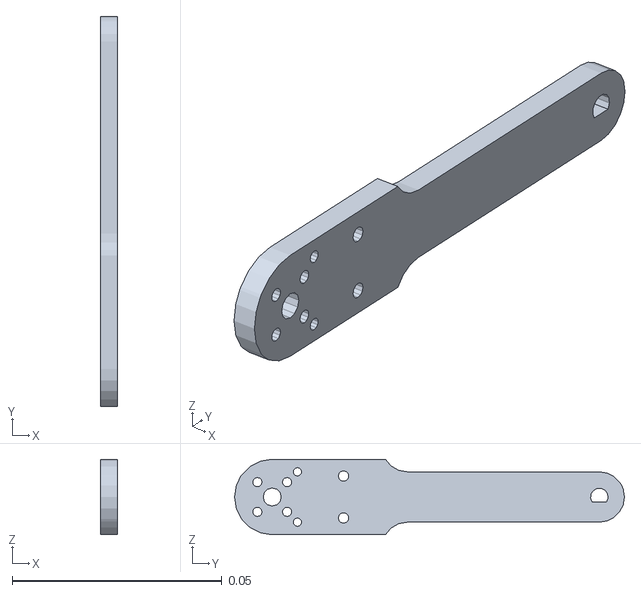
[picture p66: CAD file, 2025-06-23]
DOGlove_meshes/middle_bend_3.STL
0.004 x 0.093 x 0.018
