TEA-Lab/DOGlove/DOGlove_meshes/middle_bend_2.STL

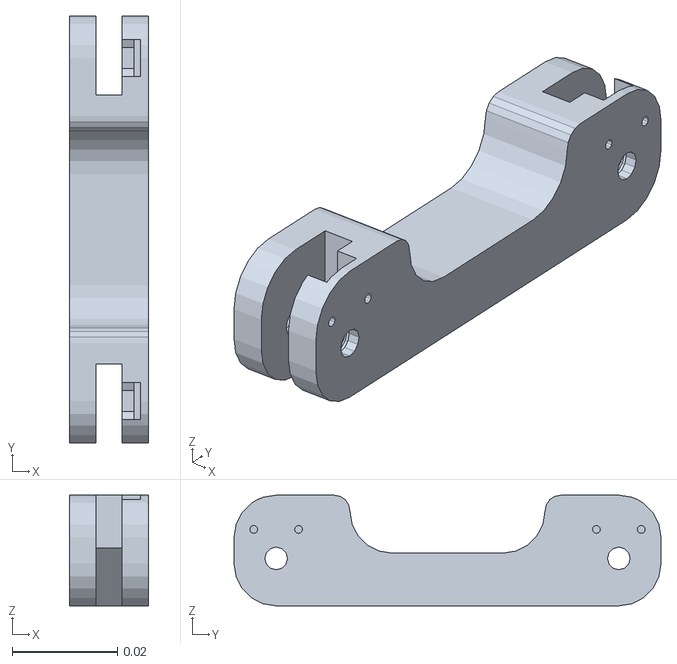
[picture p67: CAD file, 2025-06-23]
DOGlove_meshes/middle_bend_2.STL
0.015 x 0.081 x 0.021
