TEA-Lab/DOGlove/DOGlove_meshes/ring_bend_3.STL

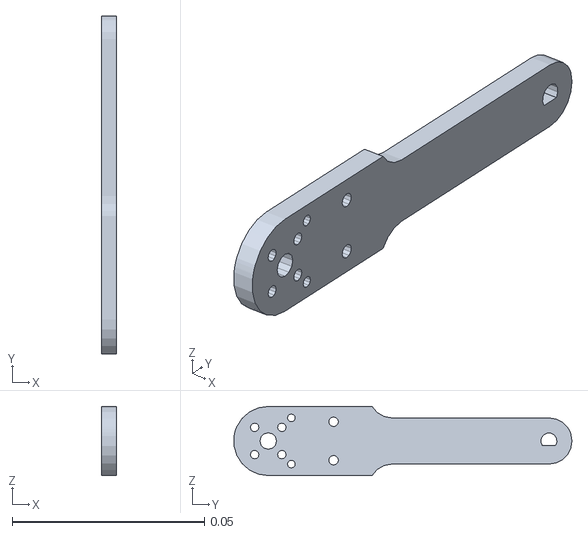
[picture p68: CAD file, 2025-06-23]
DOGlove_meshes/ring_bend_3.STL
0.004 x 0.0879 x 0.018
