TEA-Lab/DOGlove/DOGlove_meshes/thumb_bend_3.STL

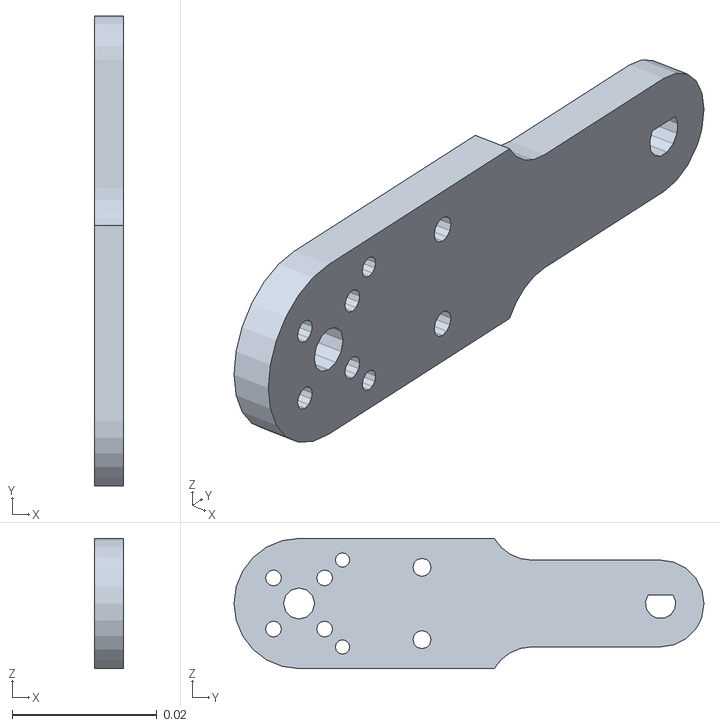
[picture p69: CAD file, 2025-06-23]
DOGlove_meshes/thumb_bend_3.STL
0.004 x 0.065 x 0.018
