TEA-Lab/DOGlove/DOGlove_meshes/thumb_mcp.STL

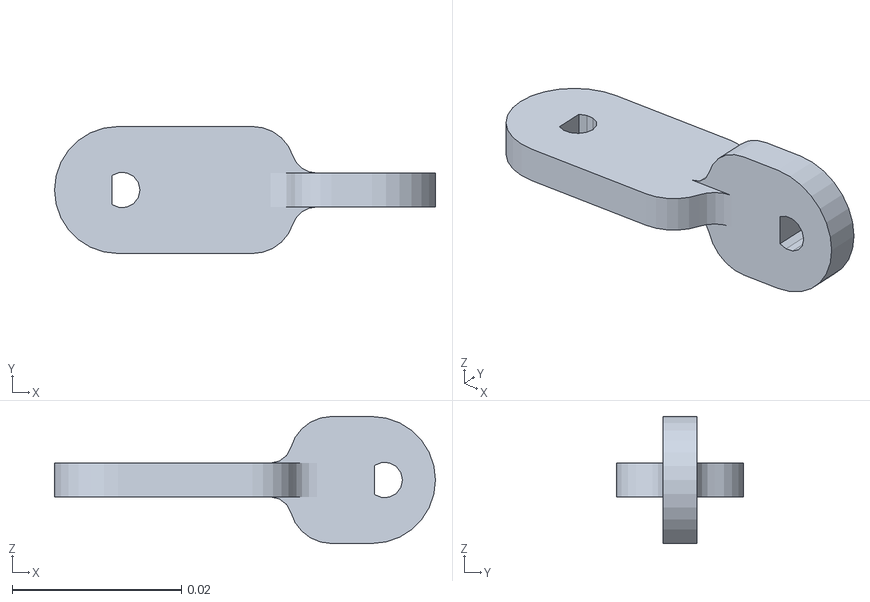
[picture p70: CAD file, 2025-06-23]
DOGlove_meshes/thumb_mcp.STL
0.045 x 0.015 x 0.015
