TEA-Lab/DOGlove/(list of files, cad)

Other CAD files:
hand_meshes/inspire_hand/meshes/Link21.STL
DOGlove_meshes/index_split.STL
hand_meshes/inspire_hand/meshes/Link15.STL
DOGlove_meshes/middle_bend_1.STL
DOGlove_meshes/ring_bend_1.STL
hand_meshes/wonik_allegro/assets/link_4.0.stl
DOGlove_meshes/index_bend_2.STL
DOGlove_meshes/pinky_split.STL
hand_meshes/wonik_allegro/assets/link_3.0_tip.stl
hand_meshes/wonik_allegro/assets/link_0.0.stl
DOGlove_meshes/pinky_bend_1.STL
hand_meshes/inspire_hand/meshes/Link17.STL
hand_meshes/wonik_allegro/assets/base_link_left.stl
DOGlove_meshes/ring_split.STL
DOGlove_meshes/index_bend_1.STL
