TEA-Lab/DOGlove/docs/quick_start/04_assemble_glove.rst

# Glove Assembly
1. Prepare the cables
./cable.mp4

2. Solder the encoders
./encoder.mp4

[Notice:] For soldering tips, you may check [YouTube] tutorials.

3. Assemble the index/middle/ring/pinky joint

4. Assemble the thumb joint

5. Assemble the palm

6. Wrap the cable
