TEA-Lab/DOGlove/hand_meshes/leap_hand/robot.urdf

<robot name="onshape">
<link name="palm_lower">
<visual>
<origin xyz="-0.020095249652862544332 0.025757756134899473244 -0.034722403578460216134" rpy="0 -0 0" />
<geometry>
<mesh filename="meshes/palm_lower.stl"/>
</geometry>
<material name="palm_lower_material">
<color rgba="0.60392156862745094426 0.14901960784313725283 0.14901960784313725283 1.0"/>
</material>
</visual>
<collision>
<origin xyz="-0.020095249652862544332 0.025757756134899473244 -0.034722403578460216134" rpy="0 -0 0" />
<geometry>
<mesh filename="meshes/palm_lower.stl"/>
</geometry>
</collision>
<inertial>
<origin xyz="0 0 0" rpy="0 0 0"/>
<mass value="0.237" />
<inertia ixx="0.000354094" ixy="-0.000001193" ixz="-0.000002445" iyy="0.000260915" iyz="-0.000002905" izz="0.000529257" />
</inertial>
</link>

<link name="mcp_joint">
<visual>
<origin xyz="0.0084069022611744960438 0.0077662438597169954416 0.014657354985032912051" rpy="1.6375789613220999807e-15 -1.0210473302491019535e-30 1.7177968783327987474e-31" />
<geometry>
<mesh filename="meshes/mcp_joint.stl"/>
</geometry>
<material name="mcp_joint_material">
<color rgba="0.86666666666666669627 0.86666666666666669627 0.050980392156862744391 1.0"/>
</material>
</visual>
<collision>
<origin xyz="0.0084069022611744960438 0.0077662438597169954416 0.014657354985032912051" rpy="1.6375789613220999807e-15 -1.0210473302491019535e-30 1.7177968783327987474e-31" />
<geometry>
<mesh filename="meshes/mcp_joint.stl"/>
</geometry>
</collision>
<inertial>
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
<parent link="thumb_dip" />
<child link="thumb_fingertip" />
<axis xyz="0 0 -1"/>
<limit effort="0.95" velocity="8.48" lower = "-1.34" upper = "1.88"/> 
<joint_properties friction="0.0"/>
</joint>

</robot>
