TEA-Lab/DOGlove/docs/_static/hardware/SCH_DOGlove_MainCircuit.pdf

# 5V-3.3V LDO

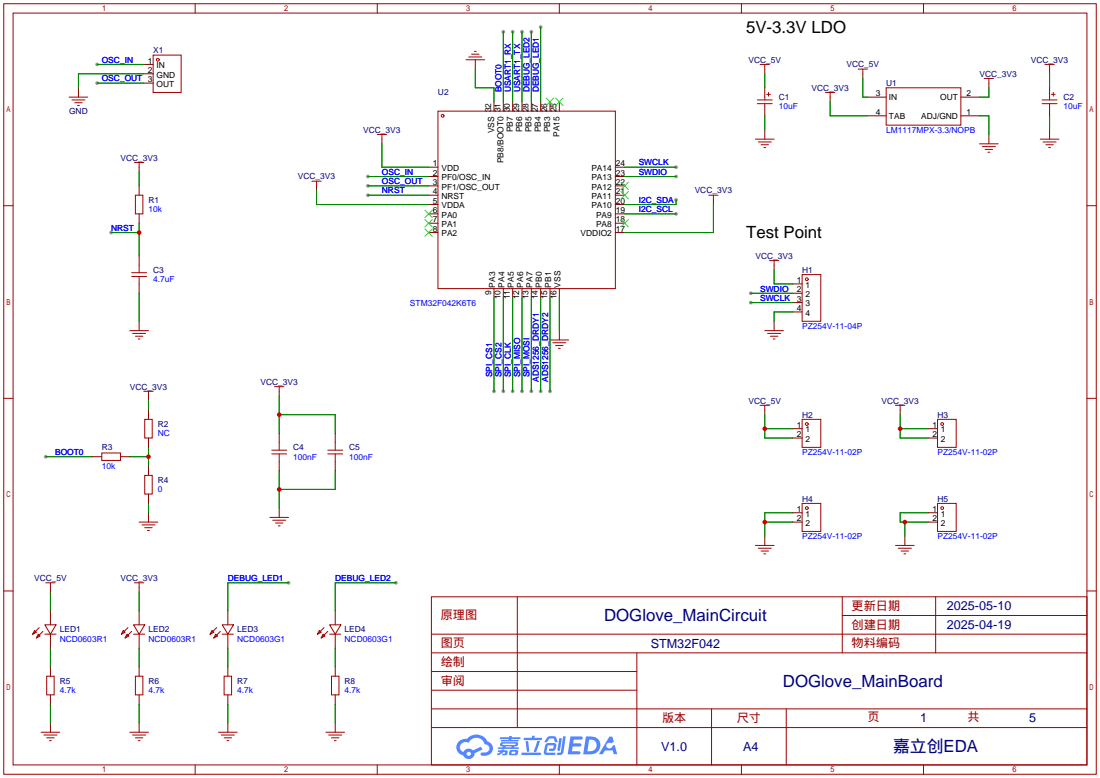
[picture p78: page 1]

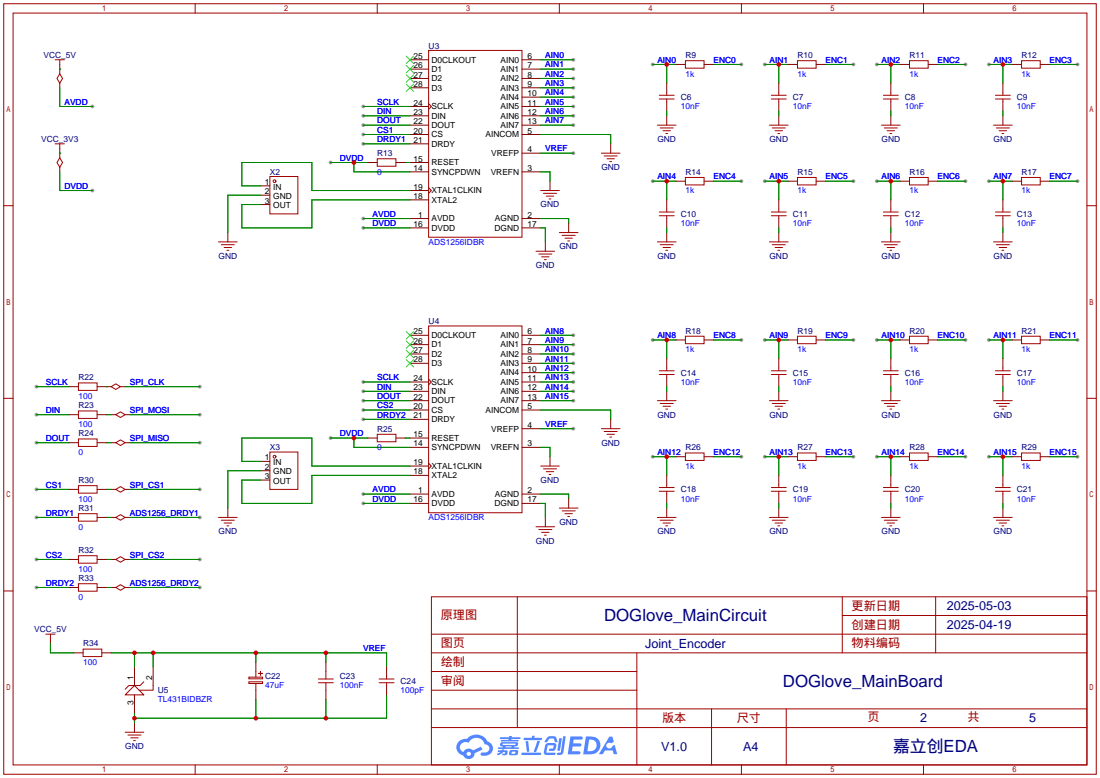
[picture p79: page 2]

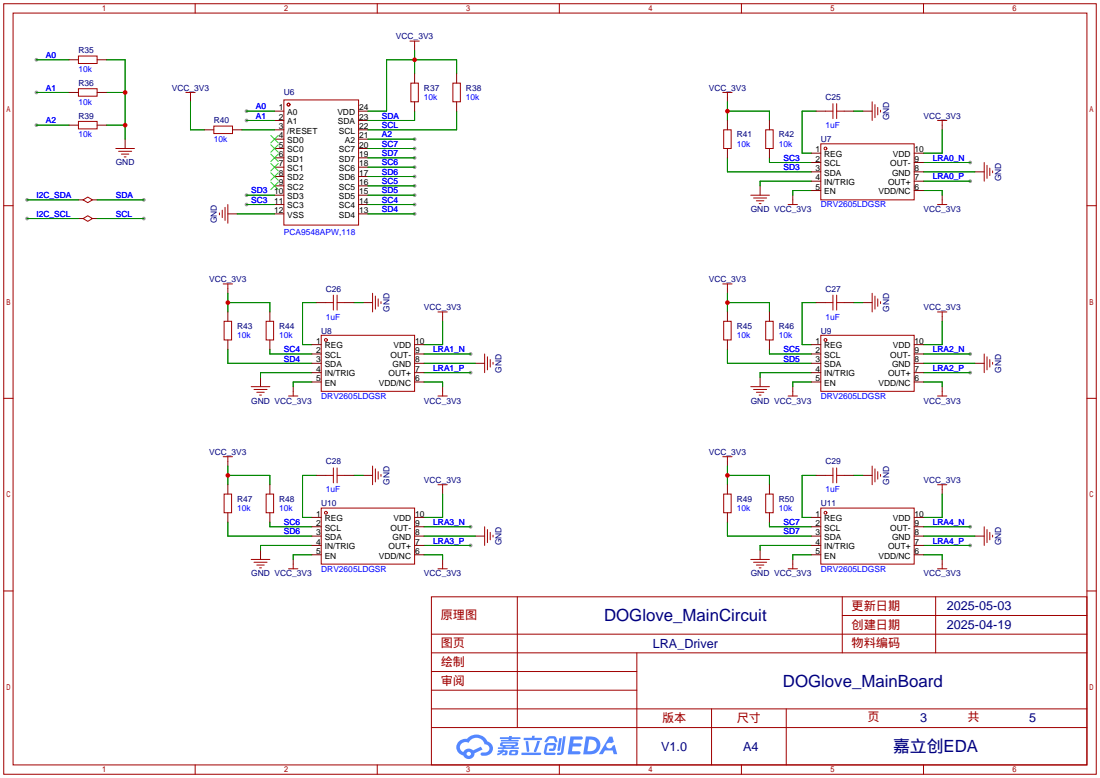
[picture p80: page 3]

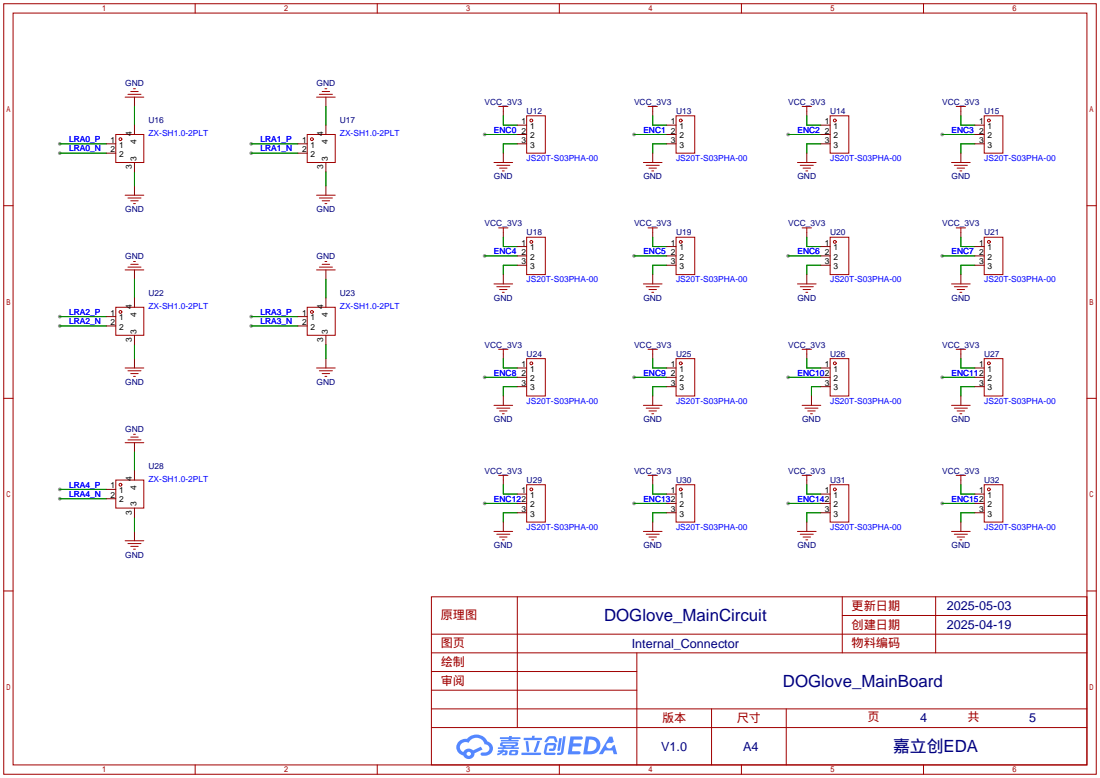
[picture p81: page 4]

U2D2

# UART

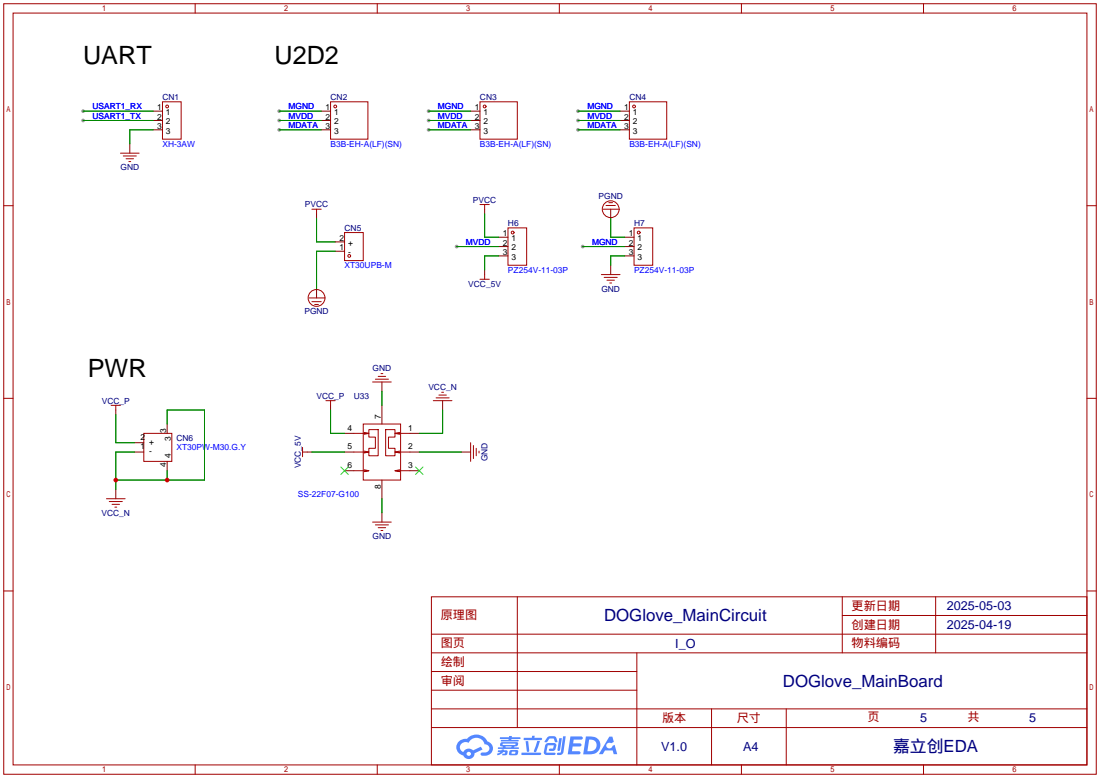
[picture p82: page 5]
