TEA-Lab/DOGlove/(commit log)

2025-06-01 Update the documentation.
    [BOM_DOGlove_MainBoard_DOGlove_MainBoard.xlsx, PickAndPlace_DOGlove_MainBoard.xlsx]
2025-06-22 Update the pcba tutorial.
2025-06-23 Update the 3d printing guide.
2025-06-23 Update tutorials.
    [DOGlove_Ver20241223.urdf, index_bend_1.STL, index_bend_2.STL, index_bend_3.STL, index_split.STL, middle_bend_1.STL, middle_bend_2.STL, middle_bend_3.STL]
2026-03-28 Clean code base and update ik script with tool scripts.
    [Link11.STL, Link12.STL, Link13.STL, Link14.STL, Link15.STL, Link16.STL, Link17.STL, Link18.STL]
